frohro/Hermes-Lite/pcb/hermes_lite.jpg

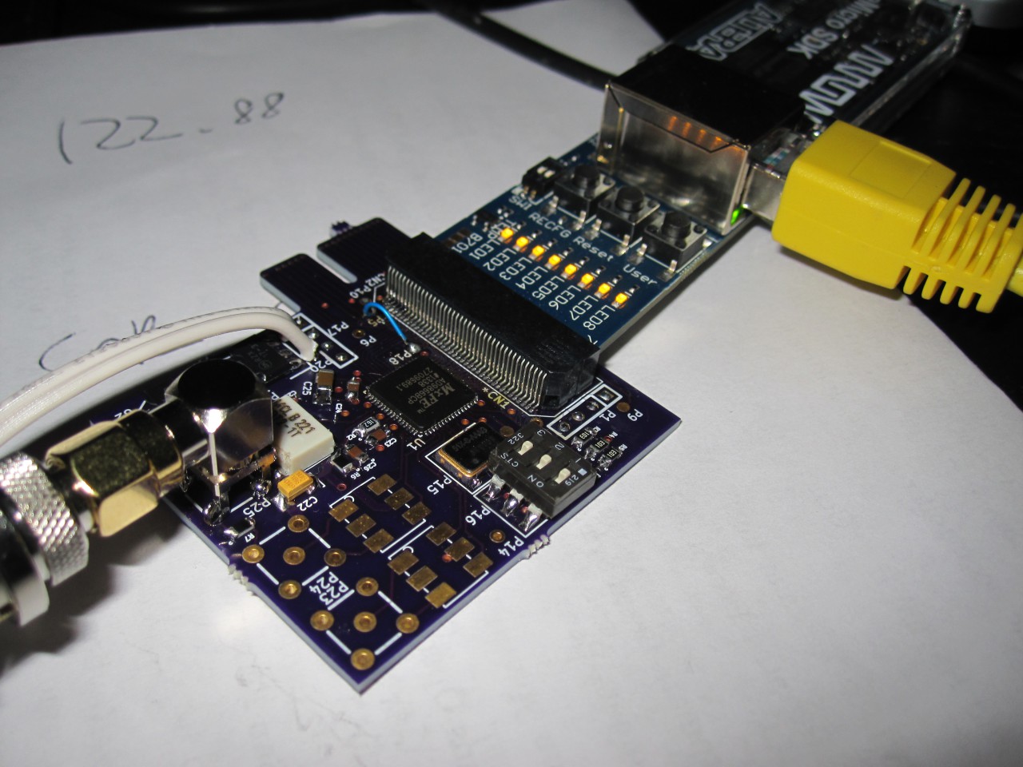
pcb/hermes_lite.jpg
