frohro/Hermes-Lite/pcb/2014-05-14 17.02.15.jpg

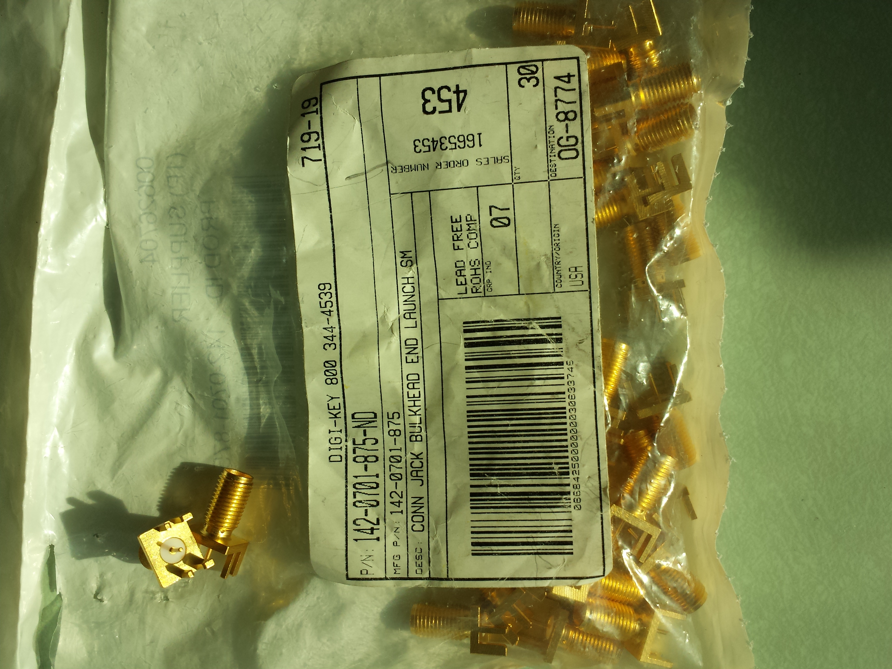
pcb/2014-05-14 17.02.15.jpg
