frohro/Hermes-Lite/pcb/bom2.xls

Designator | Quantity | Value/Description | Package | Supplier | Supplier Part # | Supplier Price | Total Price | Comments
U1 | 1 | AD9866BCPZ |  | Digi-Key | AD9866BCPZ-ND | 34.600 | 34.60
C1,C2,C3,C4,C9,C10,C11,C15,C16,C21,C23,C24,C26,C27,C28,C29,C30 | 17 | 0.1 uF | 0805 | Digi-Key | 311-1361-1-ND | 0.031 | 0.53
C5,C6,C7,C8,C12,C13,C14,C17,C18 | 9 | 1 uF | 0805 | Digi-Key | 311-1365-1-ND | 0.073 | 0.66 | Buy extra 1 for price break
C19,C20,C22,C25 | 4 | 10 uF | 1206 | Digi-Key | 399-10116-1-ND | 0.330 | 1.32 | C22 and C25 are 0805 footprint but 1206 can work
D1 | 1 | TVS Diode | SOD323 | Digi-Key | CDSOD323-T05LCCT-ND | 0.910 | 0.91 | Match voltage protection to RX transformer and AD9866 input
L1,L2,L3,L4 | 4 | Ferrite Chip | 0805 | Digi-Key | 445-1568-1-ND | 0.120 | 0.48
P15 | 1 | 73.728 Mhz XTAL |  | Digi-Key | 510CAB-AAAG-ND | 4.840 | 4.84 | Request 73.728 Mhz
P16 | 1 | 3 Pos DIP Switch |  | Digi-Key | CT2193LPST-ND | 0.690 | 0.69
R1,R3,R4,R5 | 4 | 10 K | 0805 | Digi-Key | 311-10KARCT-ND | 0.100 | 0.40
R2 | 1 | 1.6 K | 0805 | Digi-Key | 311-1.6KARCT-ND | 0.100 | 0.10
U2,U3 | 2 | 3.3 V Regulator | SOT223 | Digi-Key | NCP1117ST33T3GOSCT-ND | 0.490 | 0.98
CN1 | 1 | BeMicro Connector |  | Newark | 85T5569 | 9.990 | 9.99 | Samtec MEC6-140-02-L-D-RA1
P24, P25 | 2 | SMA Connector |  | Digi-Key | CONSMA002-ND | 3.310 | 6.62
T1 | 1 | ADT9-1T |  | Mini-Circuits | ADT9-1T | 15.950 | 15.95 | Too expensive, I bought the sampler kit, will wind my own in future
T2 | 1 | BN-43-2402 |  | Amidon | BN-43-2402 | 0.700 | 0.70 | 3T bifilar on primary, 5T on secondary, 1.2:1 ratio, need 1.41 in future
FPGA | 1 | BeMicro SDK |  | Arrow | BEMICRO SDK | 35.860 | 35.86 | While supplies last, use BeMicro CV in future?
PCB | 1 | PCB |  | OshPark | Gerber Files | 38.700 | 38.70 | 1 Batch of 3 boards, other suppliers may be cheaper
 |  | Micro USB B jack |  | Digi-Key | 609-4618-1-ND | 0.460 | 0.46 | FCI 10118194-0001LF
 |  |  |  |  |  |  | 153.32
