frohro/Hermes-Lite/pcb/ad9866.ods

Id | Designator | Package | Quantity | Designation | Supplier and ref
1 | P25,P24,P23 | SMA_EDGE:SMA_EDGE | 3 | CONN_2
2 | U1 | AD986:CP_64_3-M | 1 | AD9866BCPZ
3 | C1,C2,C3,C4,C9,C10,C11,C15,C16,C21,C23,C24,C26,C27,C28,C29,C30 | SMD_Packages:SM0805 | 17 | 0.1UF
4 | C5,C6,C7,C8,C12,C13,C14,C17,C18 | SMD_Packages:SM0805 | 9 | 1UF Rob substituted 10UF Ceramics
5 | C19,C20,C22 | SMD_Packages:SM1206POL | 3 | 10UF Rob substituted 33UF
6 | C25 | SMD_Packages:SM1206 | 1 | 10UF
7 | D1 | SOD:SOD323 | 1 | CDSOD323
8 | L1,L2,L3,L4 | SMD_Packages:SM0805 | 4 | FB
9 | P15 | SILABS:Si510 | 1 | Si510 73.728
10 | R1 | SMD_Packages:SM0805 | 1 | 10K
11 | R2 | SMD_Packages:SM0805 | 1 | 1.6K
12 | R6,R7 | SMD_Packages:SM0805 | 2 | DNI
13 | T2,T3 | MINICKTS:minicircuits-CD542 | 2 | TRANSF_ADT2
14 | U2,U3 | SMD_Packages:SOT223 | 2 | NCP1117ST33T3G
15 | P8,P13,P20,P6,P14,P19 | Measurement_Points:Measurement_Point_Round-TH_Small | 6 | CONN_1
16 | P9,P10,P22 | Measurement_Points:Measurement_Point_Round-SMD-Pad_Small | 3 | CONN_1
17 | T1 | MINICKTS:minicircuits-CD542 | 1 | TRANSF_ADT8
18 | CN1 | BEMICRO:MEC6-140-02-X-D-RAX | 1 | MEC6-140_CONNECTOR_BEMICRO
19 | P1 | Pin_Headers:Pin_Header_Straight_1x02 | 1 | CONN_2
 | Red font for surface mount front, Blue font for surface mount back
