frohro/Hermes-Lite/pcb/micro-b-usb-3D/AB2_USB_MICRO_SMD.stl

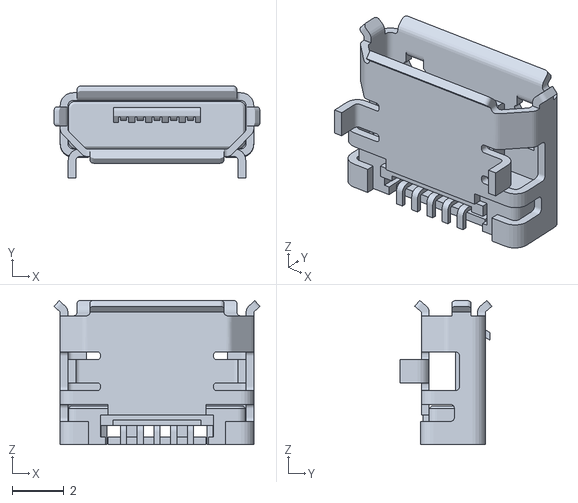
[picture p3: CAD file, 2014-06-20]
pcb/micro-b-usb-3D/AB2_USB_MICRO_SMD.stl
8.00 x 3.57 x 5.60
