frohro/Hermes-Lite/pcb/SCM_BeMicroSDK-A2-1.pdf

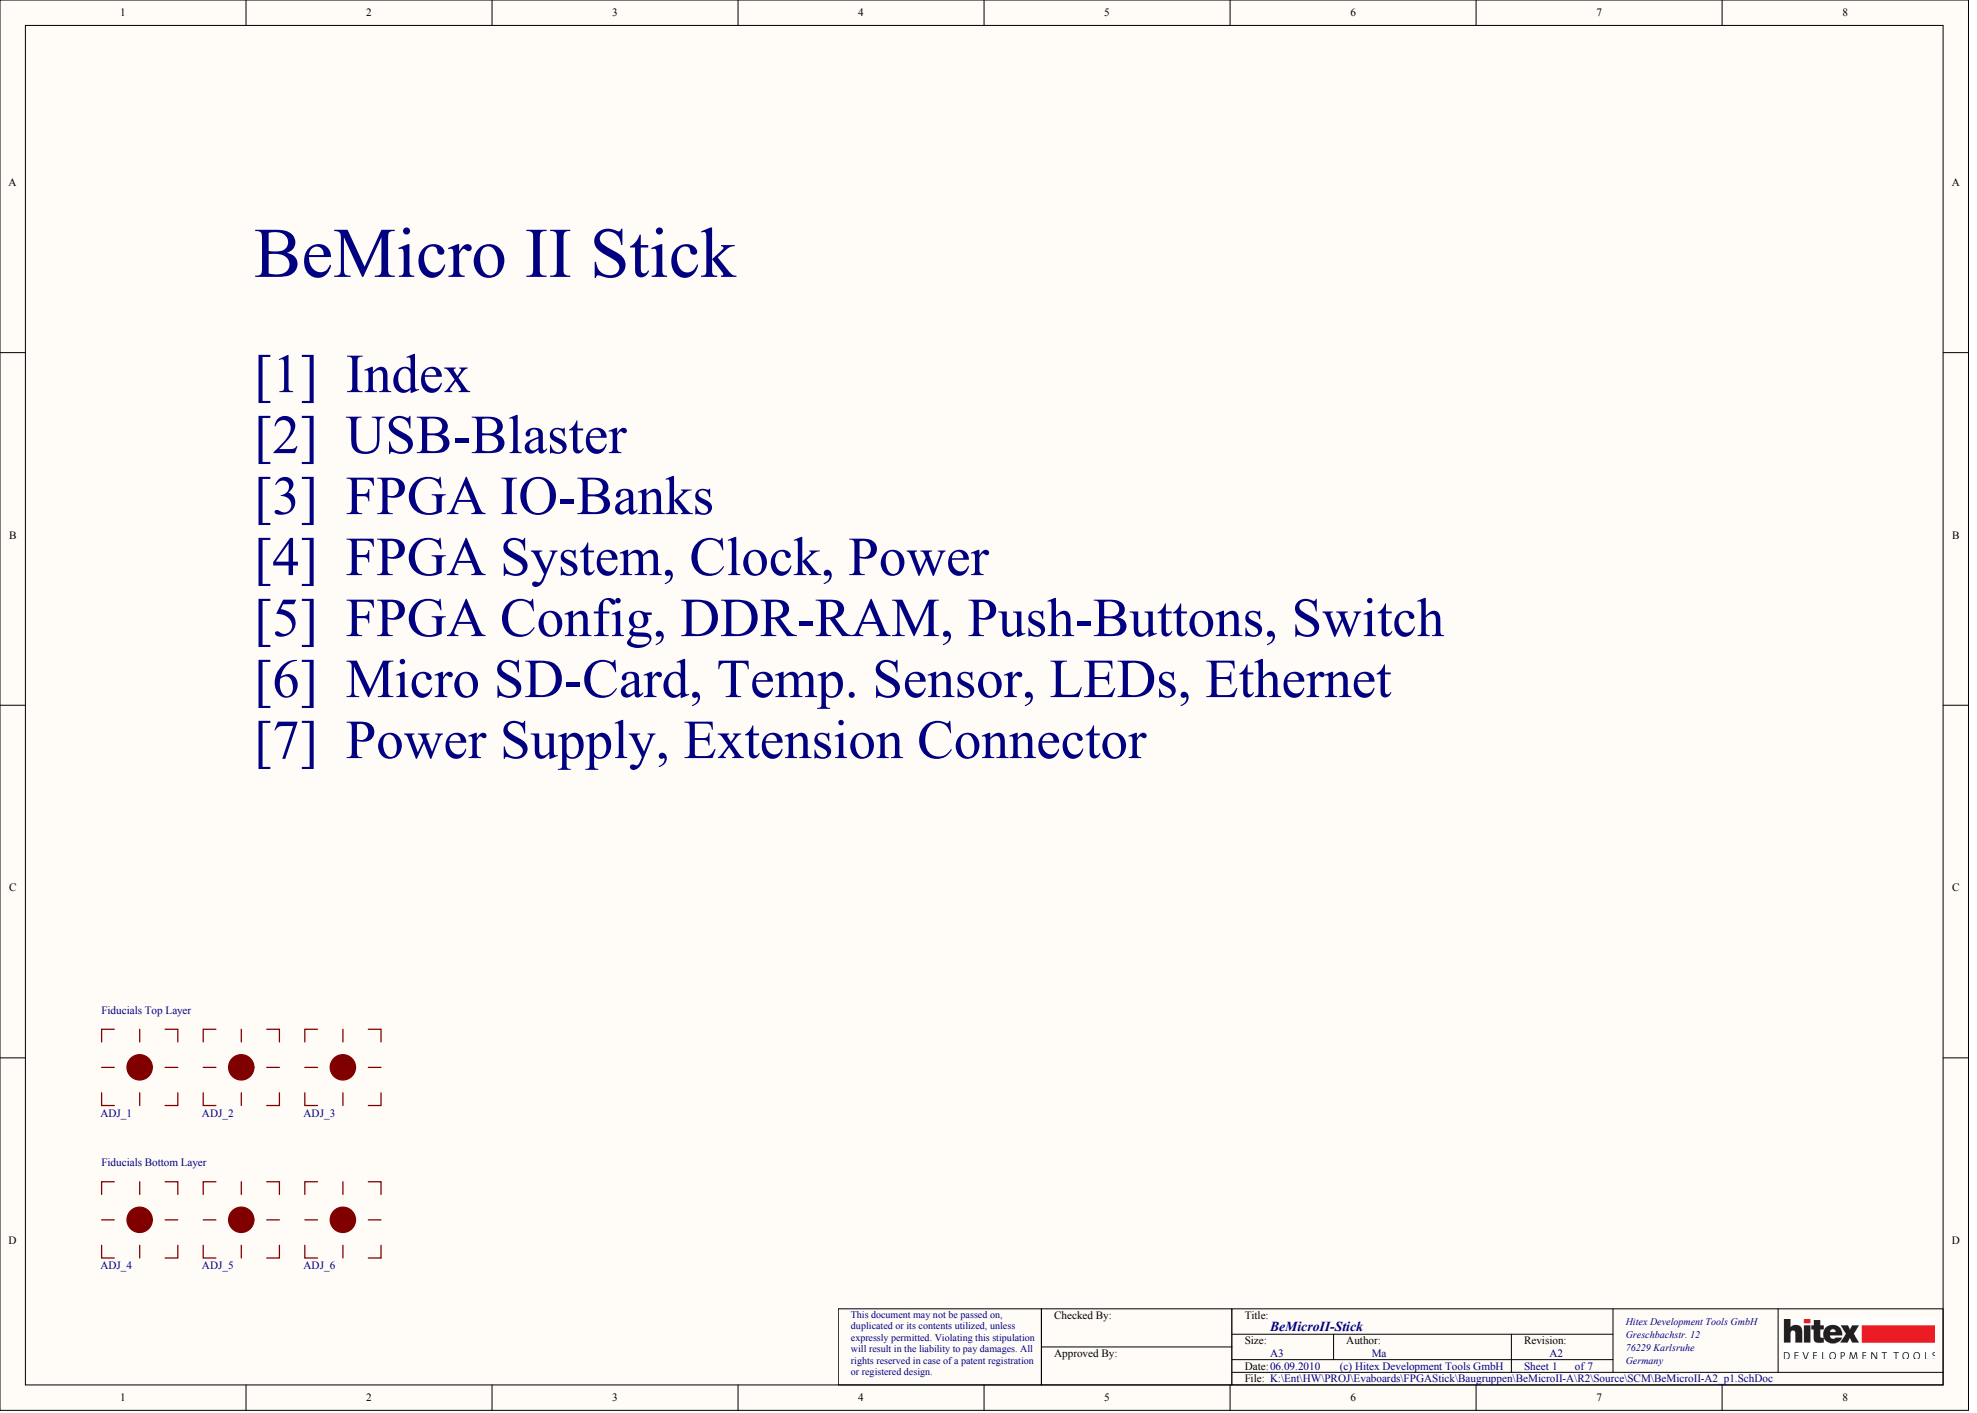
[picture p4: page 1]

[1] Index
[2] USB-Blaster
[3] FPGA IO-Banks
[4] FPGA System, Clock, Power
[5] FPGA Config, DDR-RAM, Push-Buttons, Switch
[6] Micro SD-Card, Temp. Sensor, LEDs, Ethernet
[7] Power Supply, Extension Connector

This document may not be passed on, duplicated or its contents utilized, unless expressly permitted. Violating this stipulation will result in the liability to pay damages. All rights reserved in case of a patent registration or registered design. | Checked By: | Title: BeMicroII-Stick | Hitex Development Tools GmbH Greschbachstr. 12 76229 Karlsruhe

Size: A3 | Author: Ma | Revision: A2

Date: 06.09.2010 (c) Hitex Development Tools GmbH | | of 7 | Germany Sheet 1

K:\Ent\HW\PROJ\Evaboards\FPGAStick\Baugruppen\BeMicroII-A\R2\Source\SCM\BeMicroII-A2_p1.SchDoc

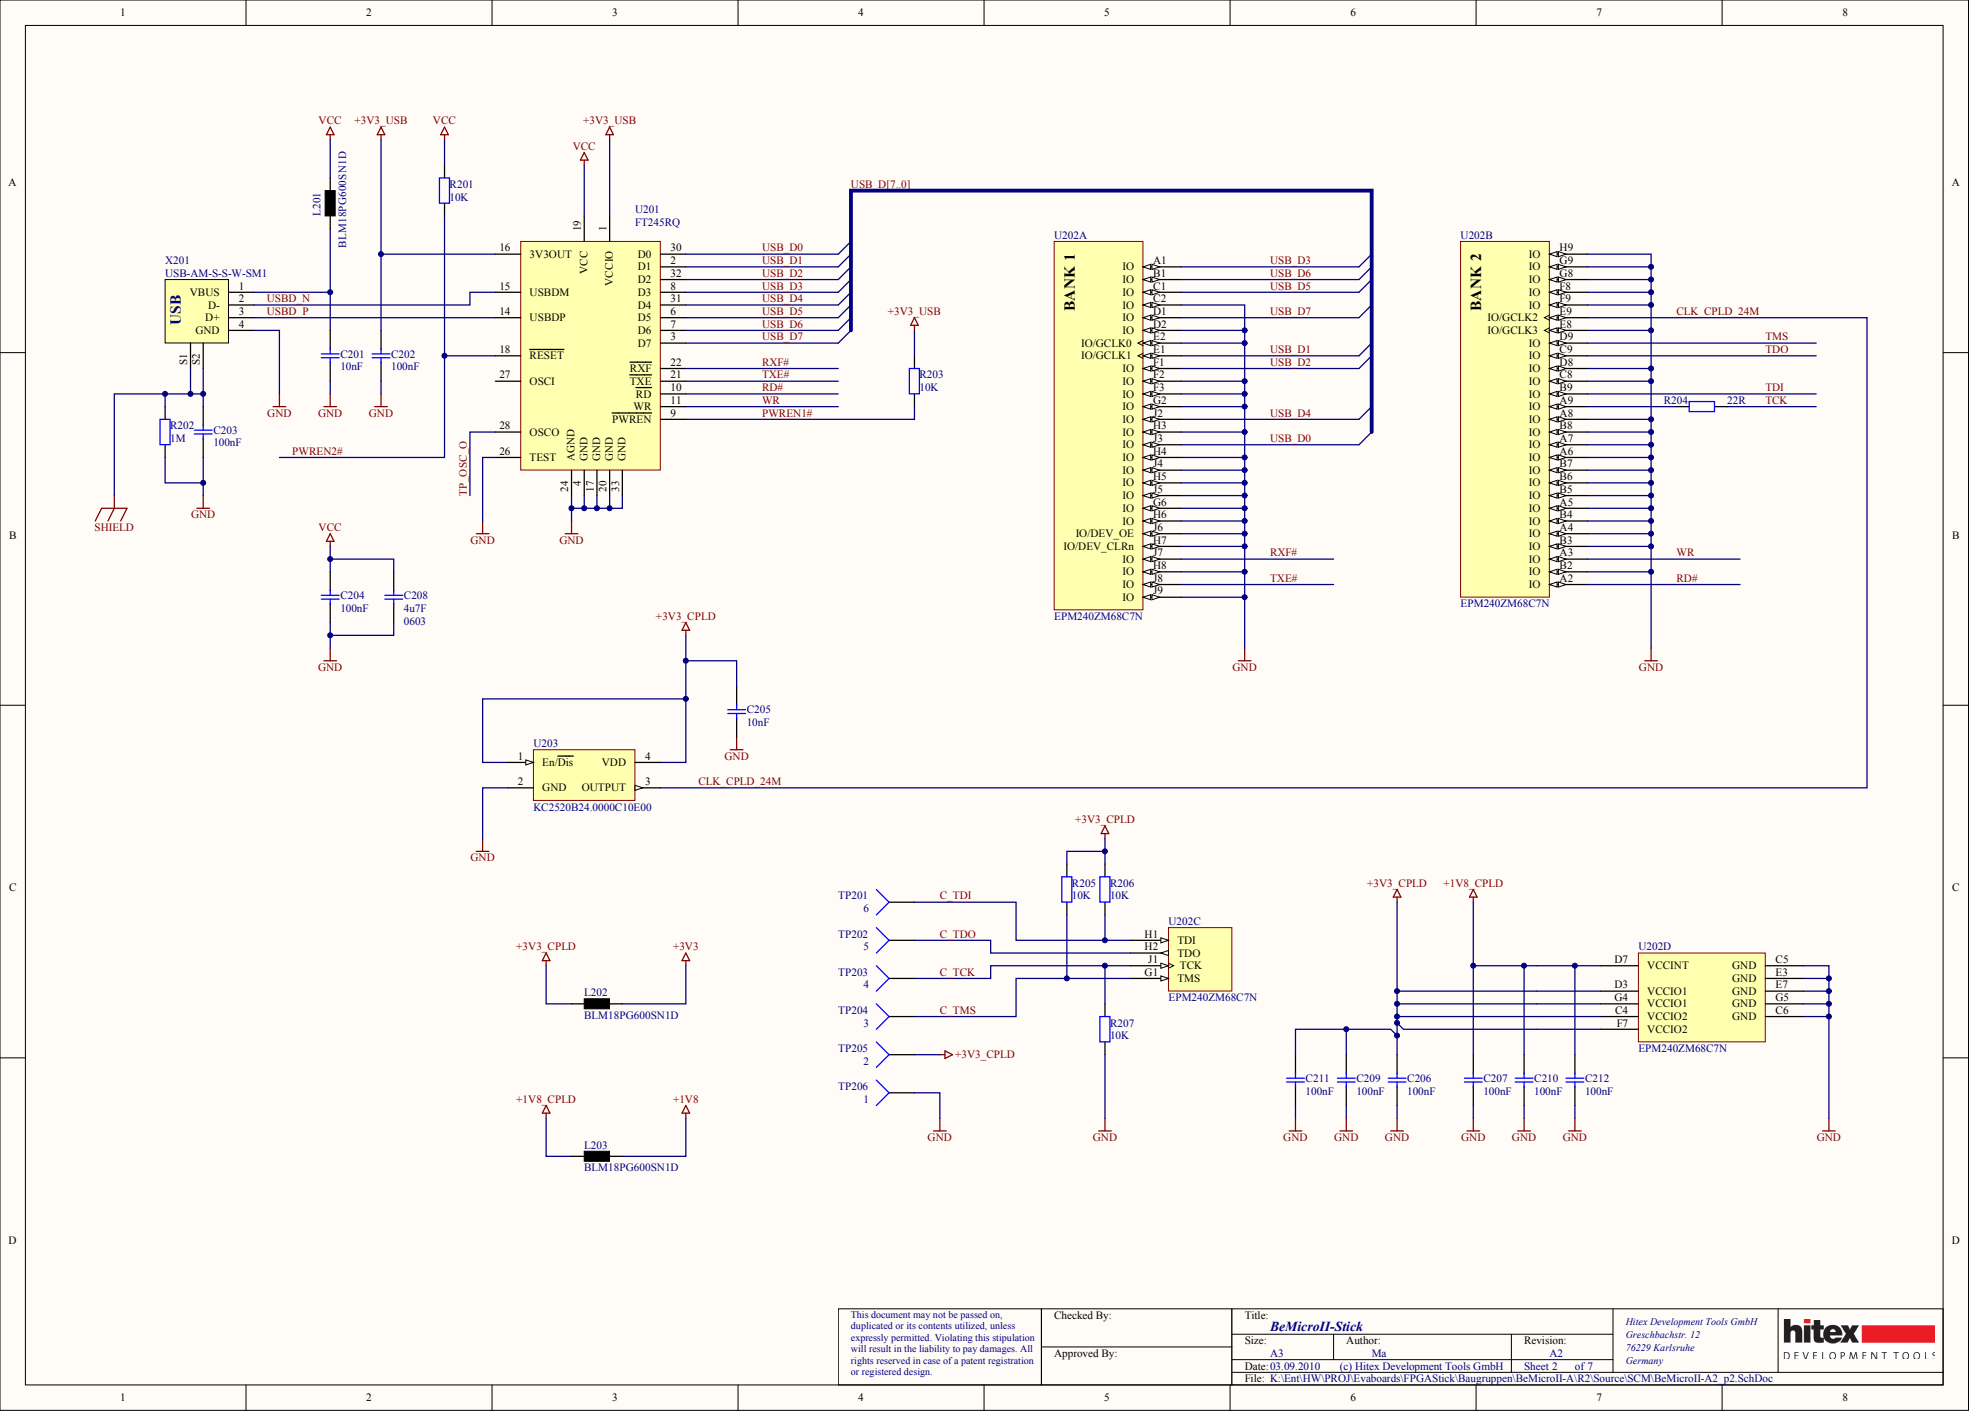
[picture p5: page 2]

K:\Ent\HW\PROJ\Evaboards\FPGAStick\Baugruppen\BeMicroII-A\R2\Source\SCM\BeMicroII-A2_p2.SchDoc

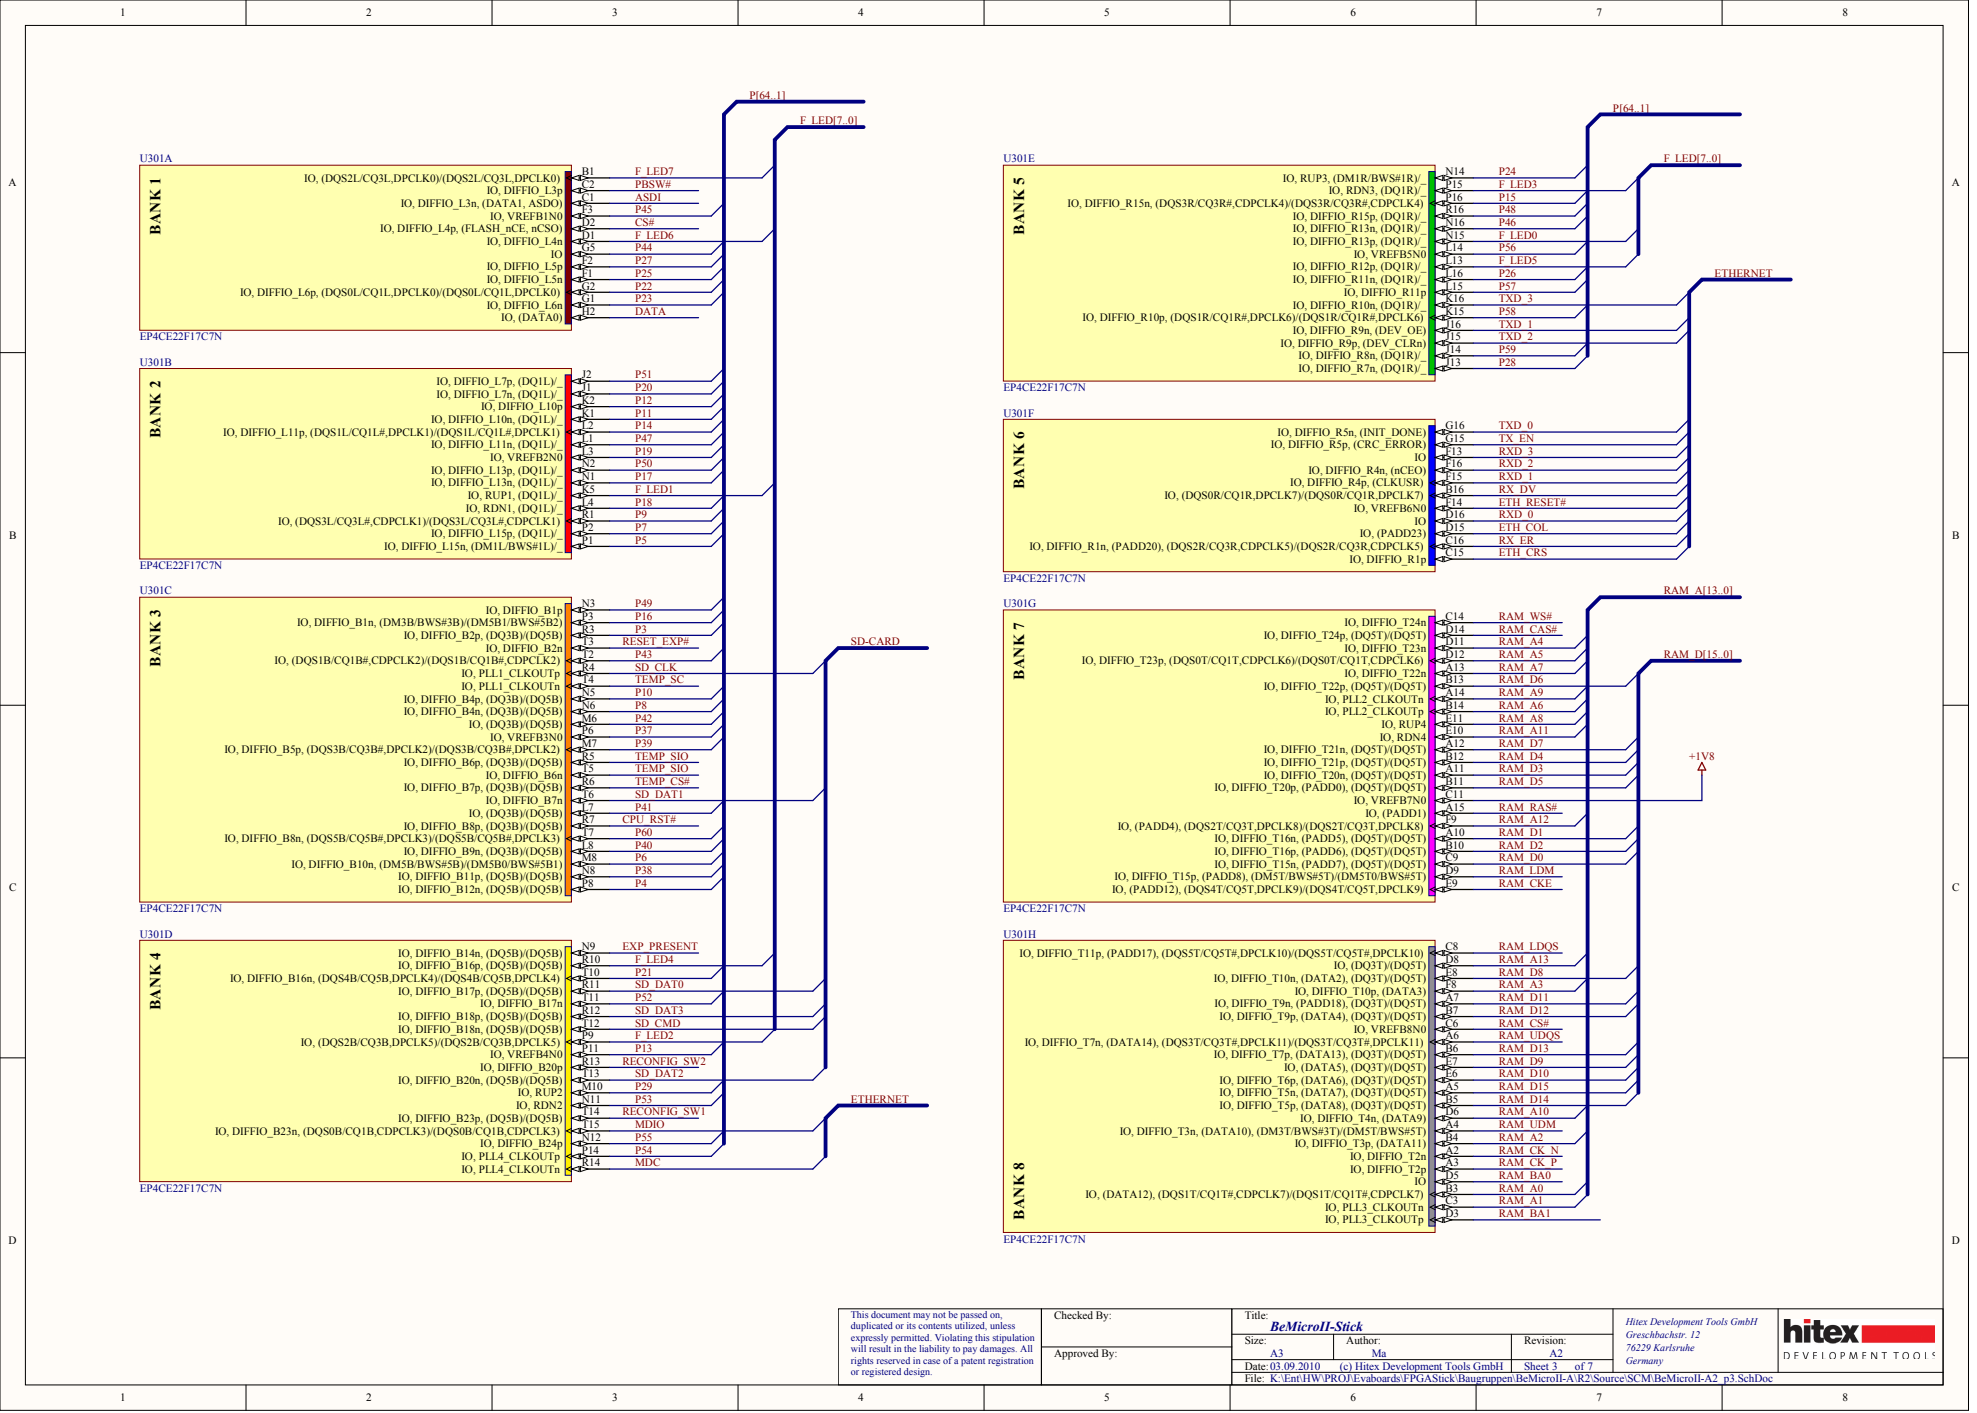
[picture p6: page 3]

03.09.2010 K:\Ent\HW\PROJ\Evaboards\F

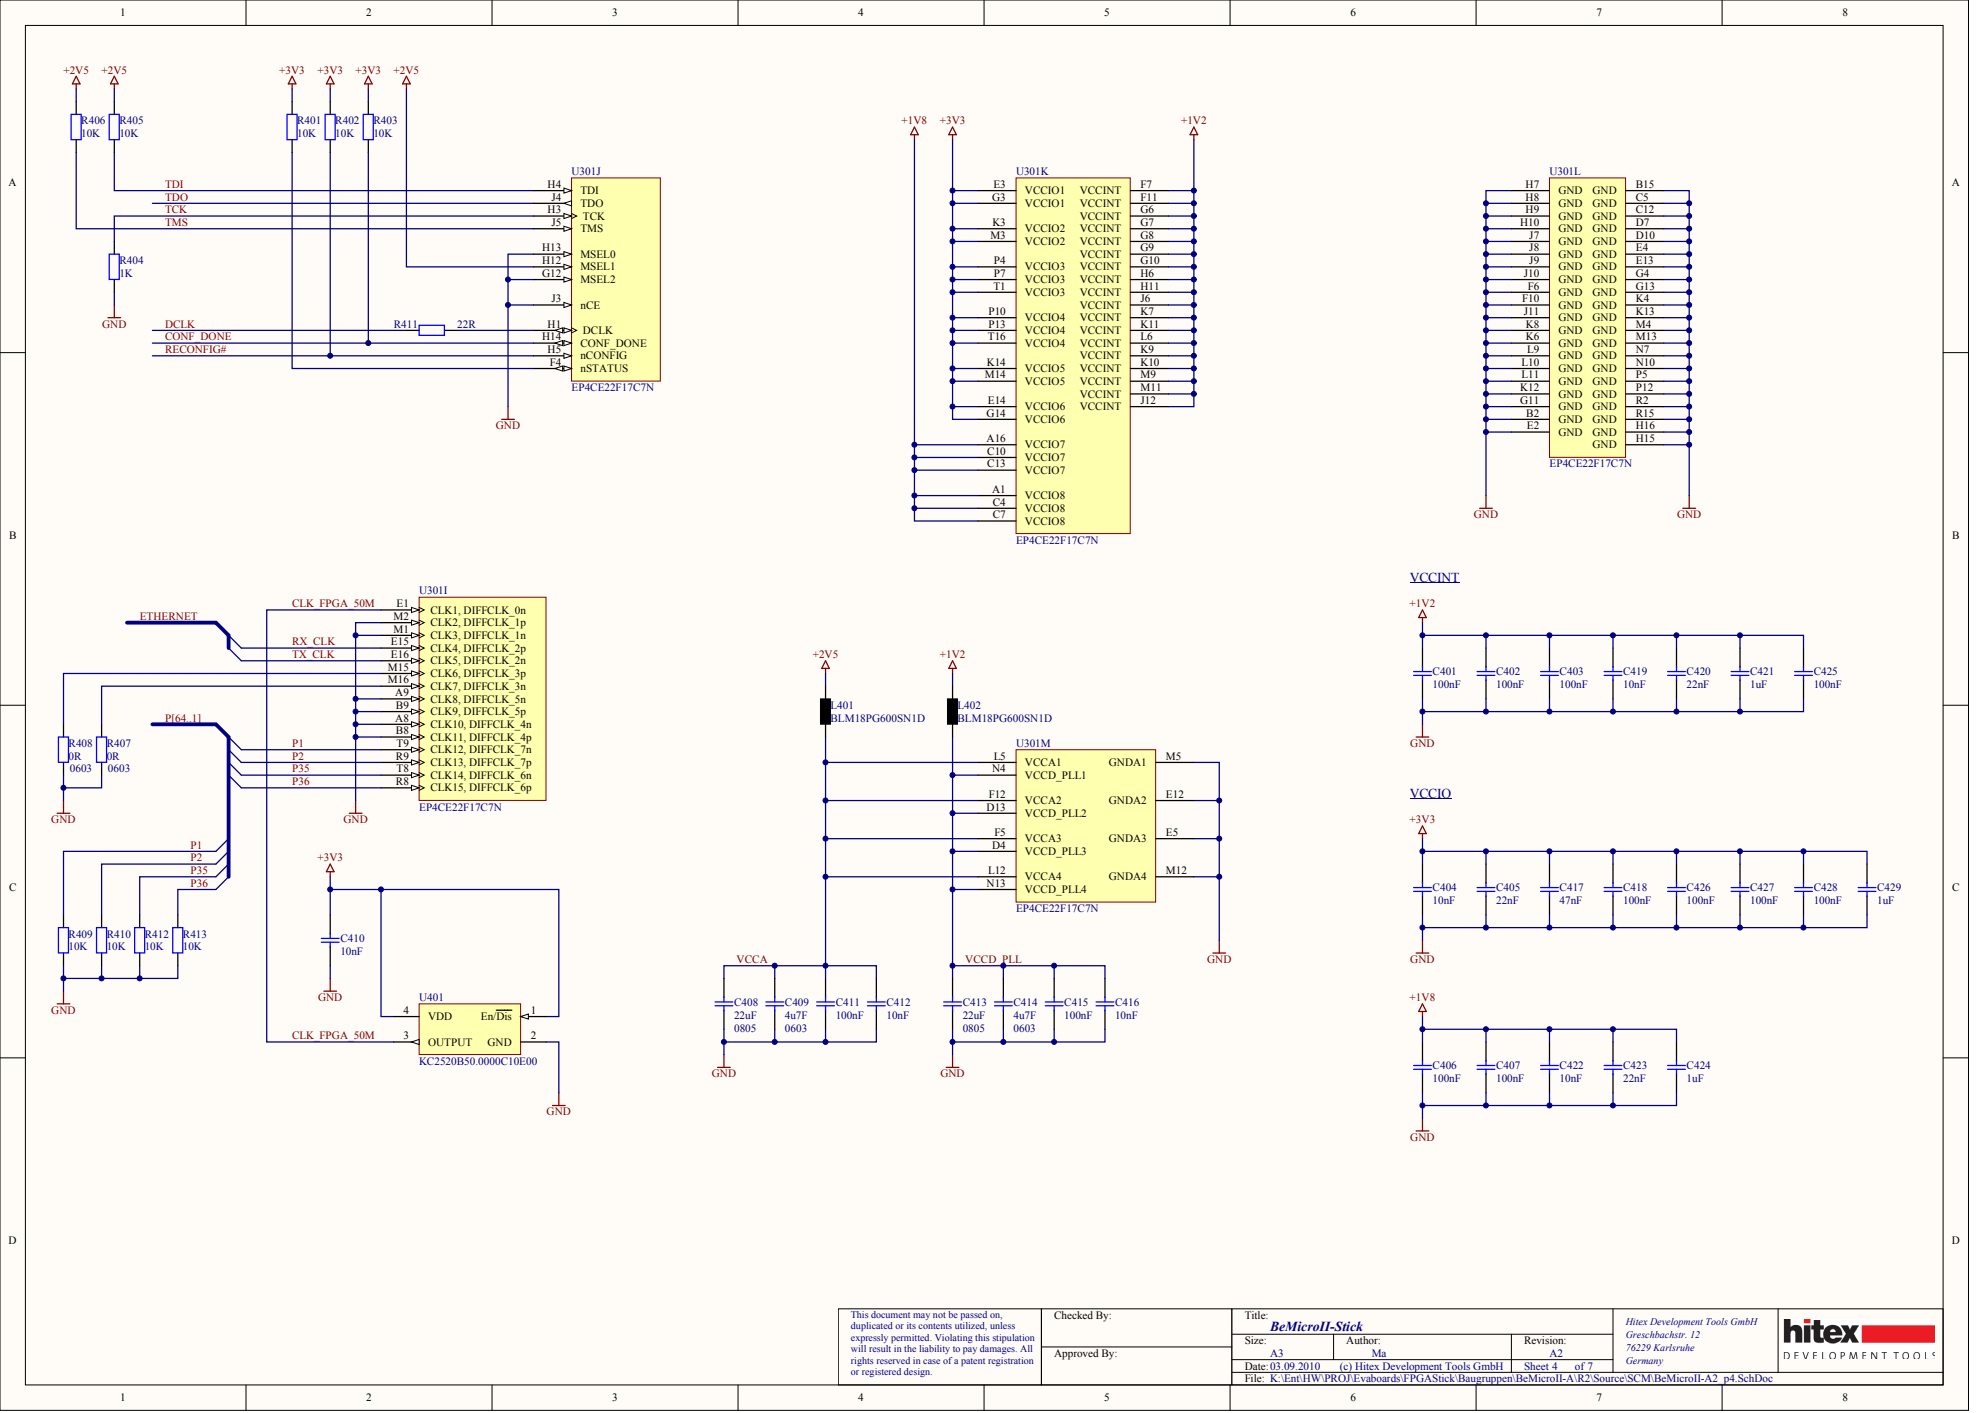
[picture p7: page 4]

VCCIO7 C10
VCCIO7 C13

VCCIO8 A1
VCCIO8 C4
VCCIO8 C7

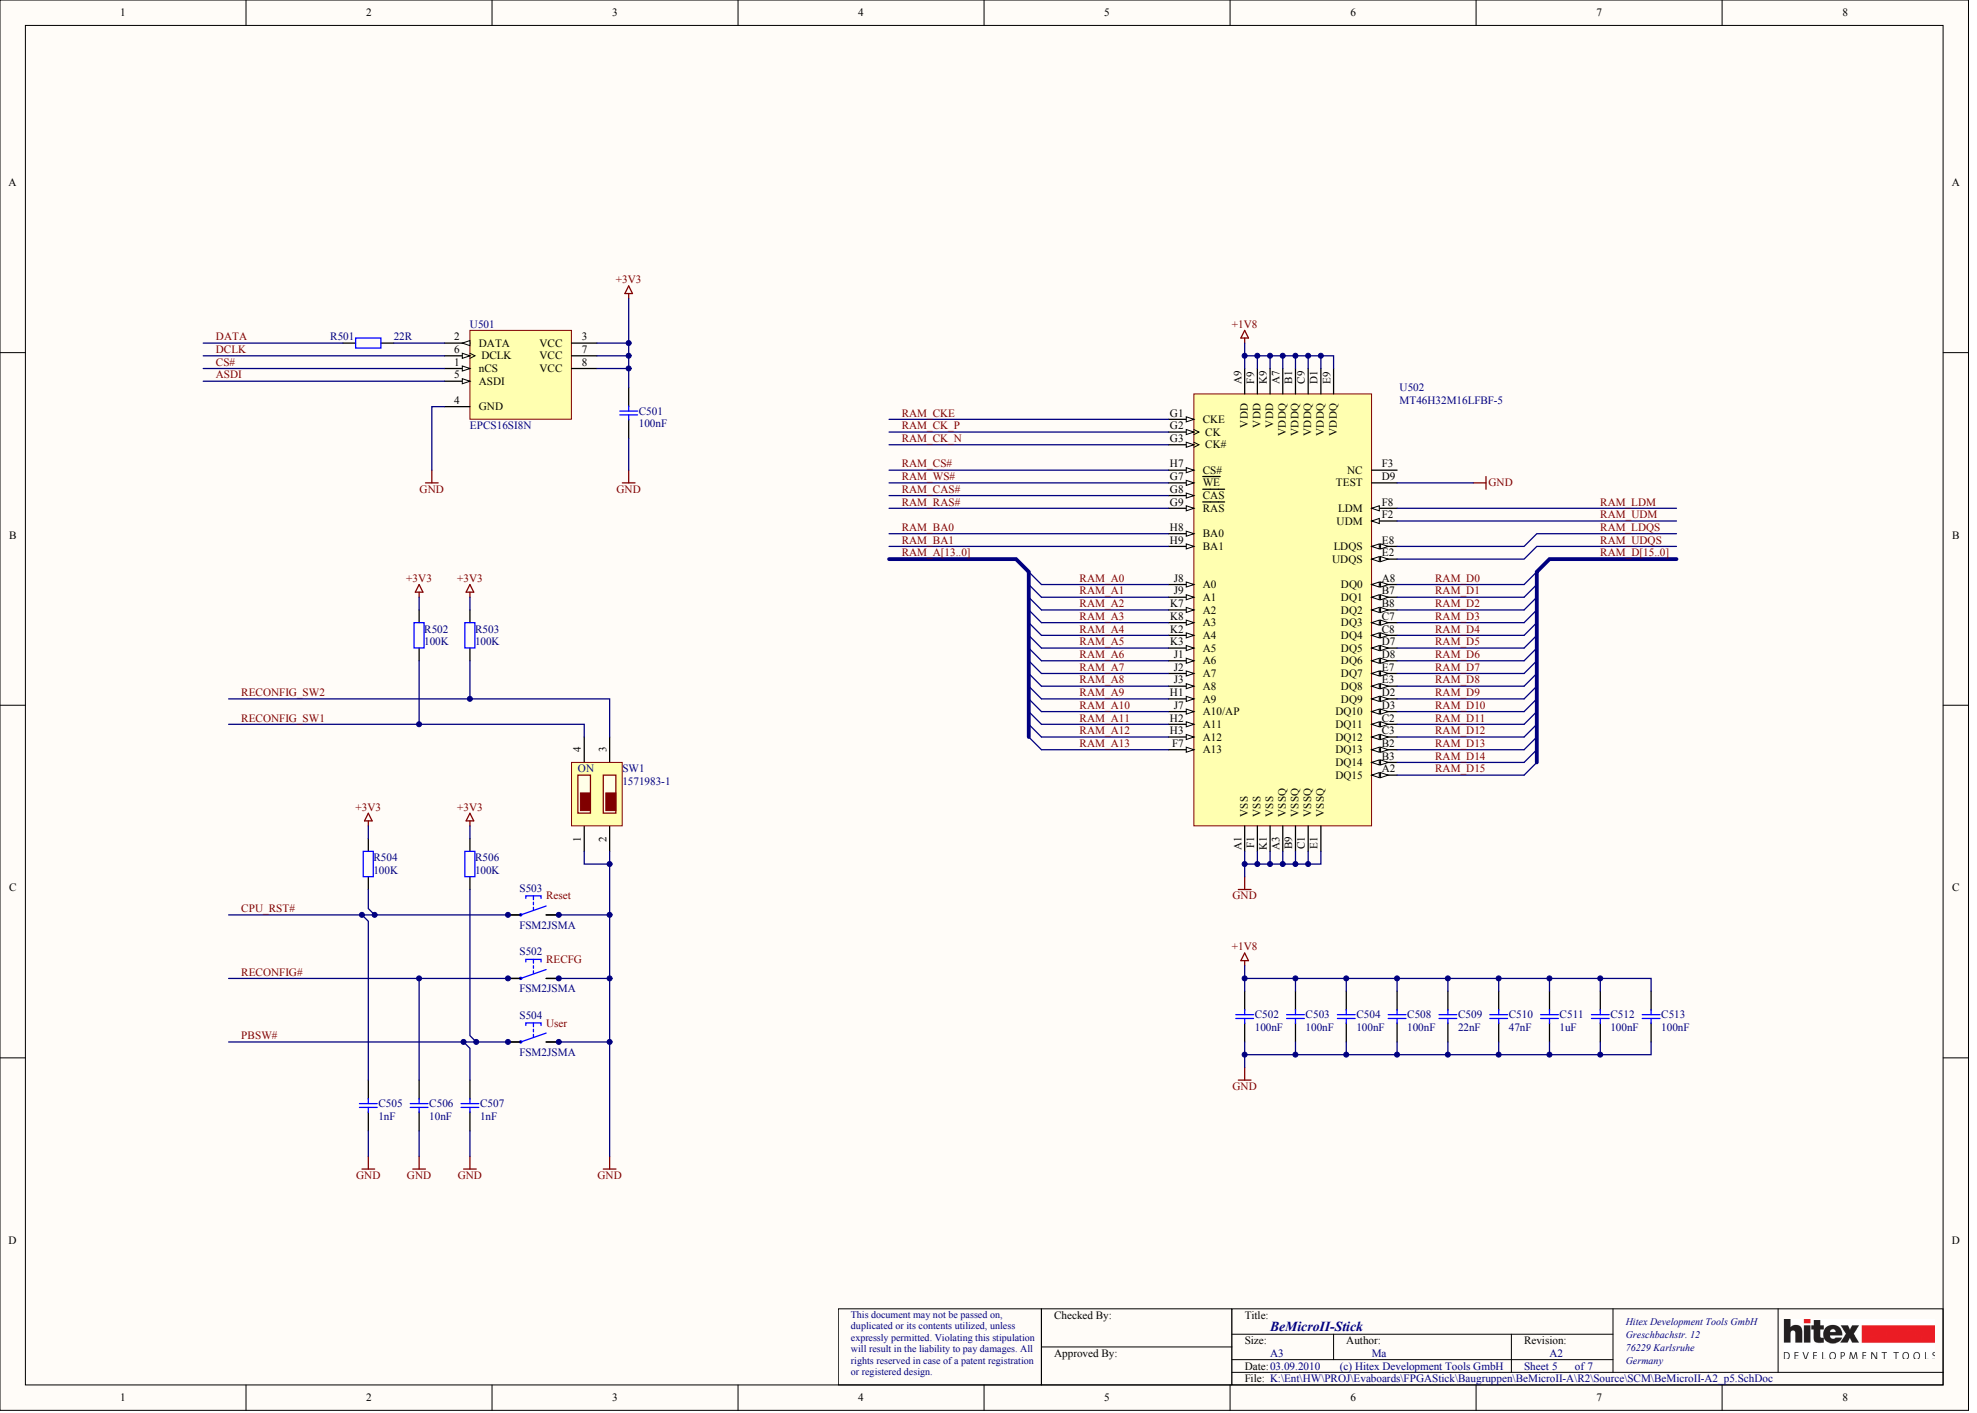
[picture p8: page 5]

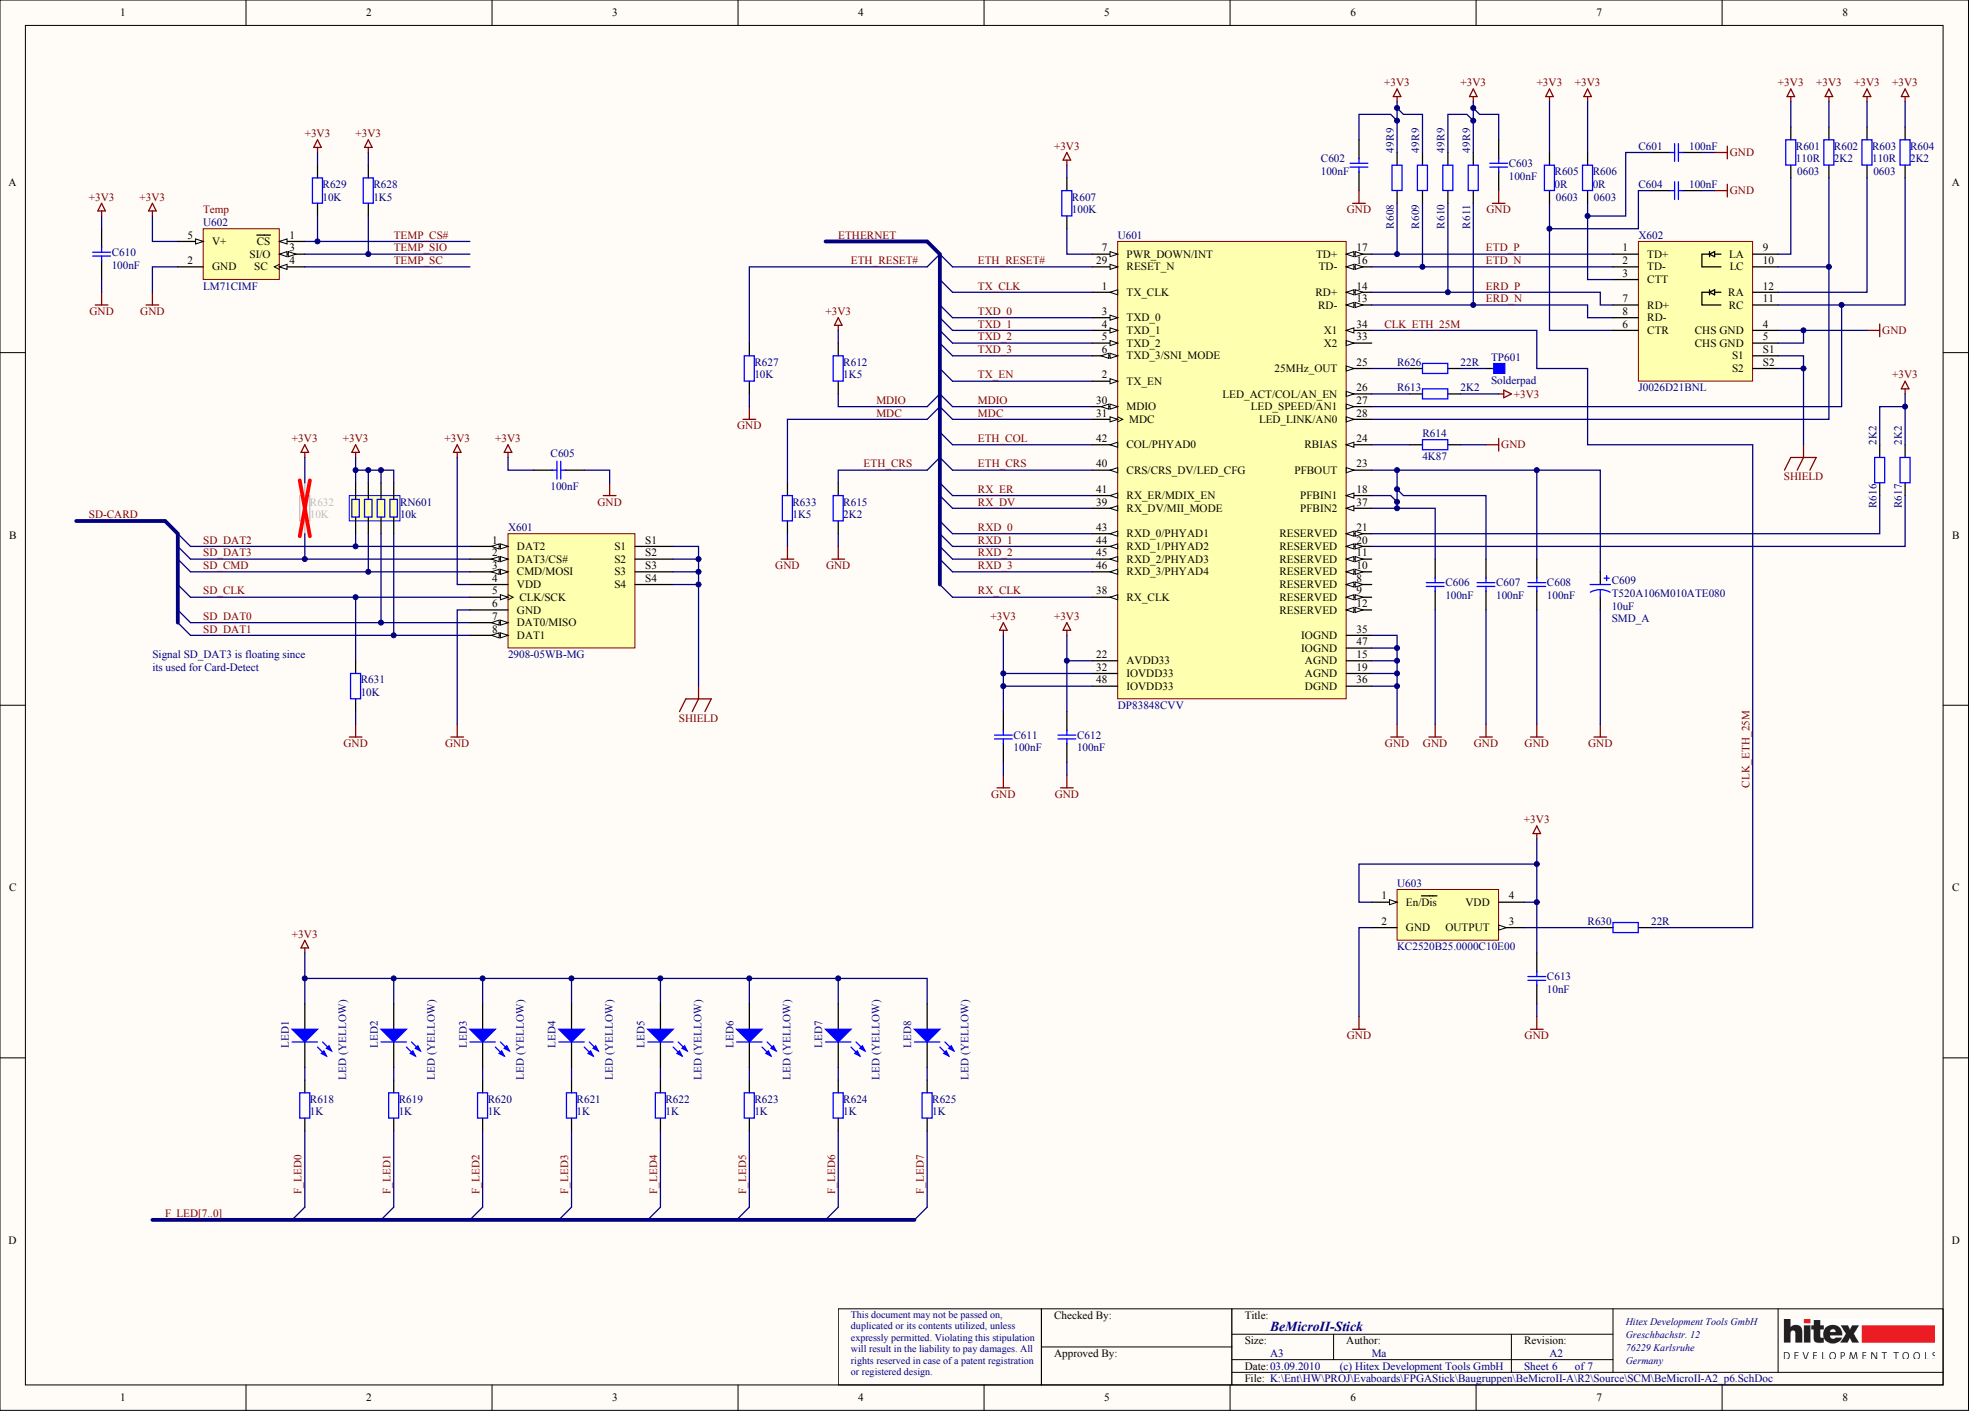
[picture p9: page 6]

Signal SD_DAT3 is floating since
its used for Card-Detect

K:\Ent\HW\PROJ\Evaboards\FPGAStick\Baugruppen\BeMicroII-A\R2\Source\SCM\BeMicroII-A2_p6.SchDoc

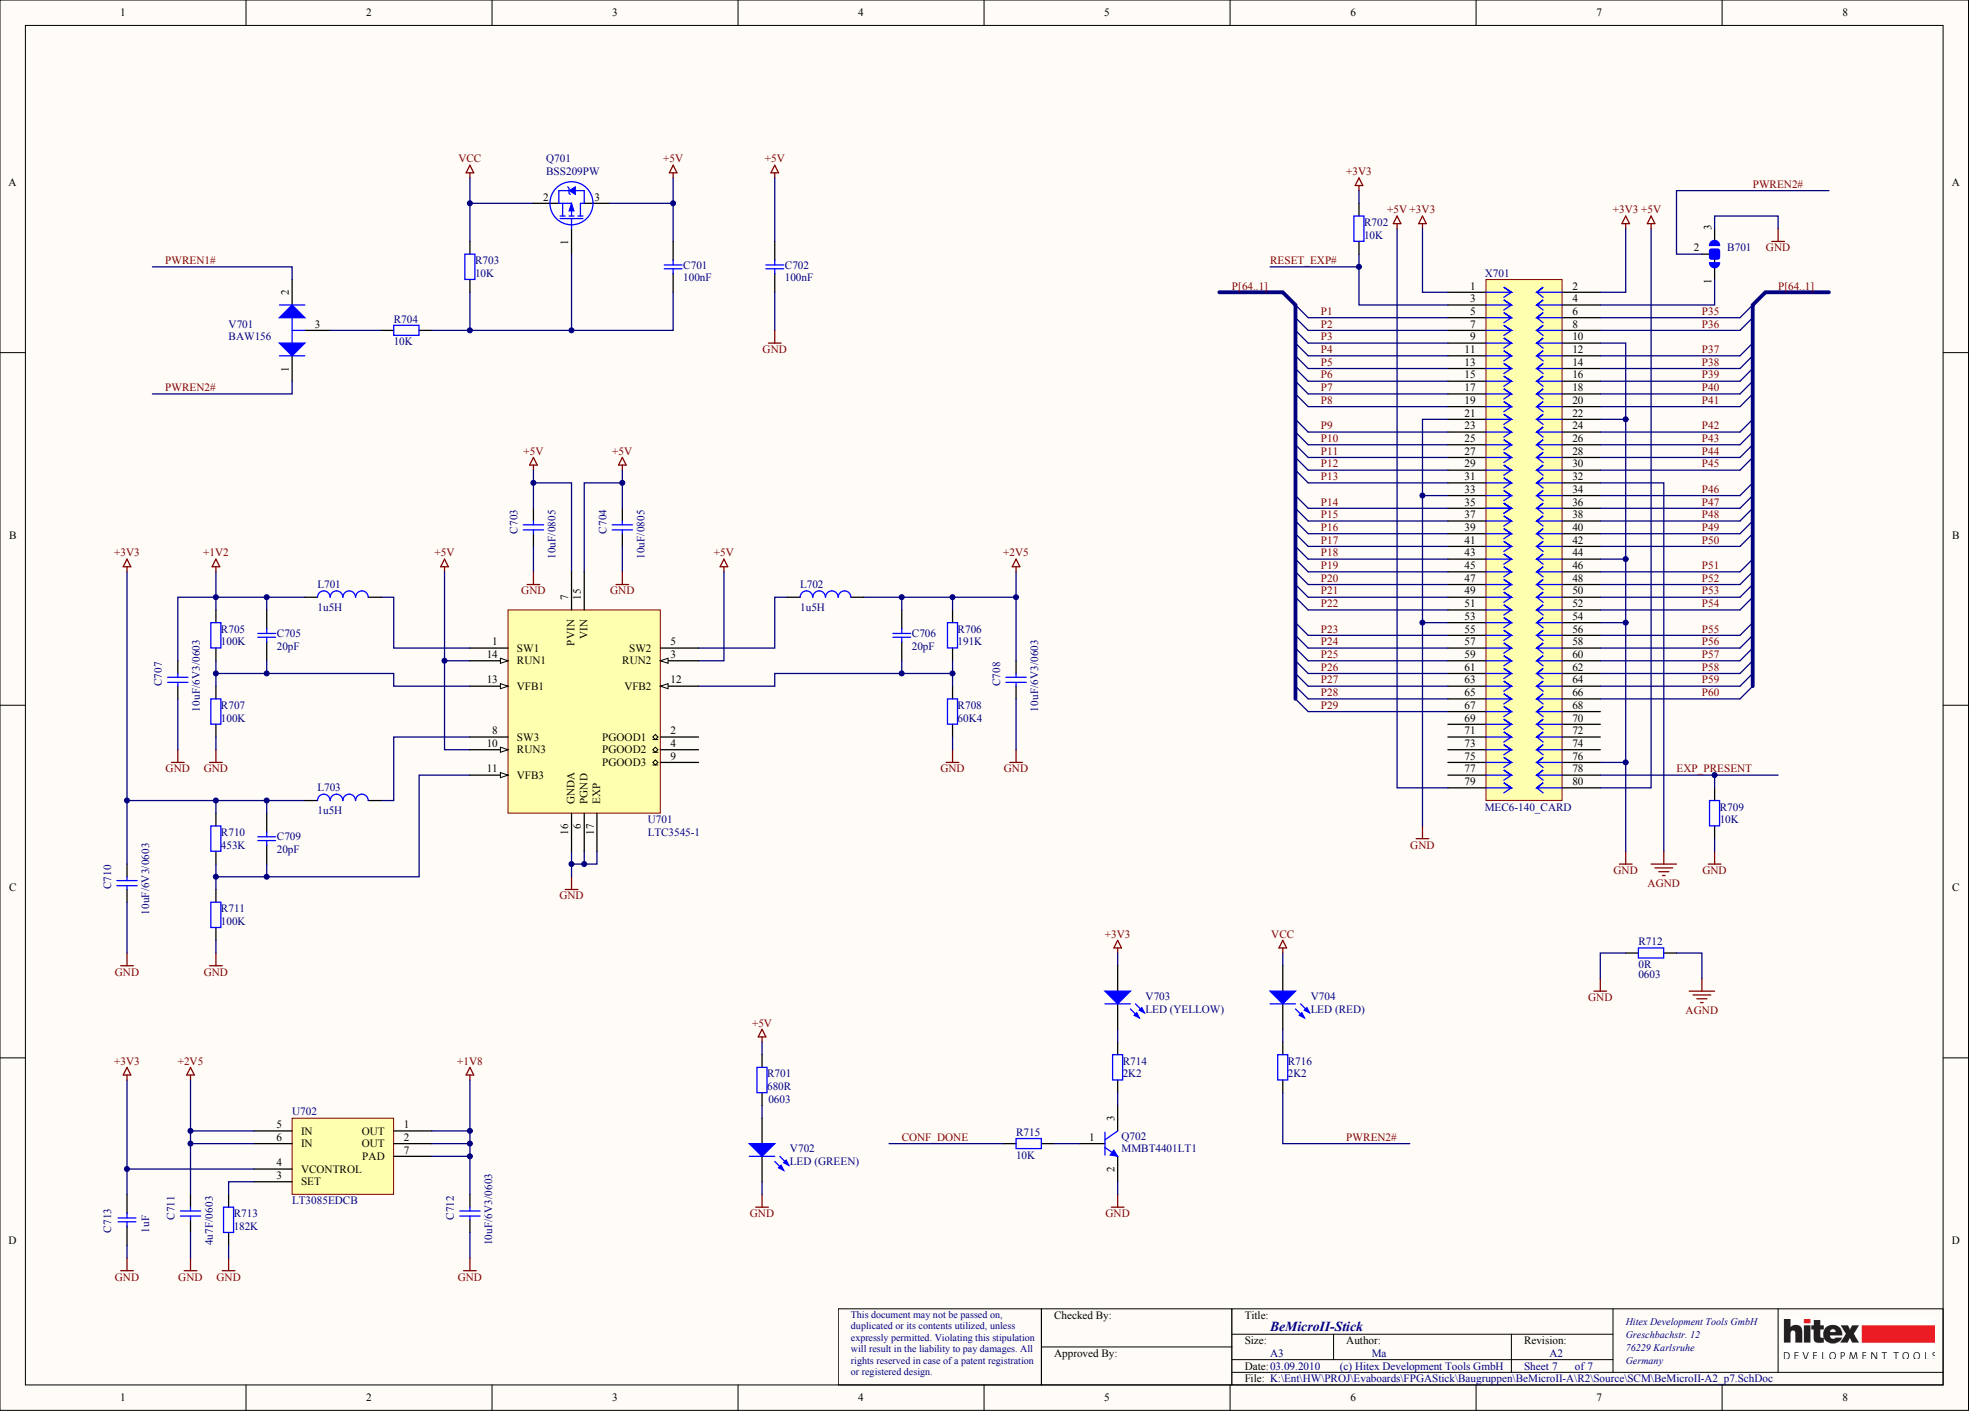
[picture p10: page 7]

5 7 9 11 13 15 17 19 21 | | 6 8 10

34 36 38 40 42 44
35 37 39 41 43 45 47 49 51 53
