frohro/Hermes-Lite/pcb/PDF Plots/ad9866_2test-Inner1_Cu.pdf

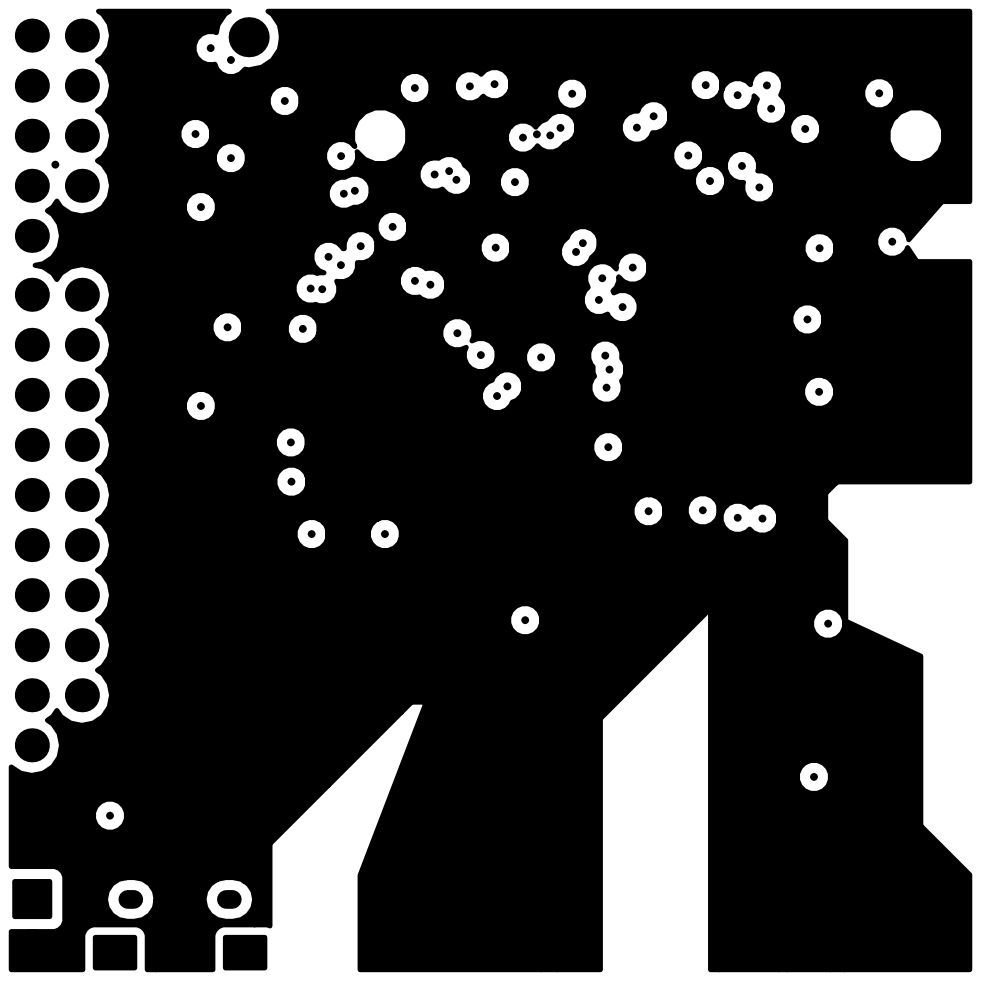
[picture p11: page 1]
