frohro/Hermes-Lite/pcb/PDF Plots/ad9866_2test-Inner2_Cu.pdf

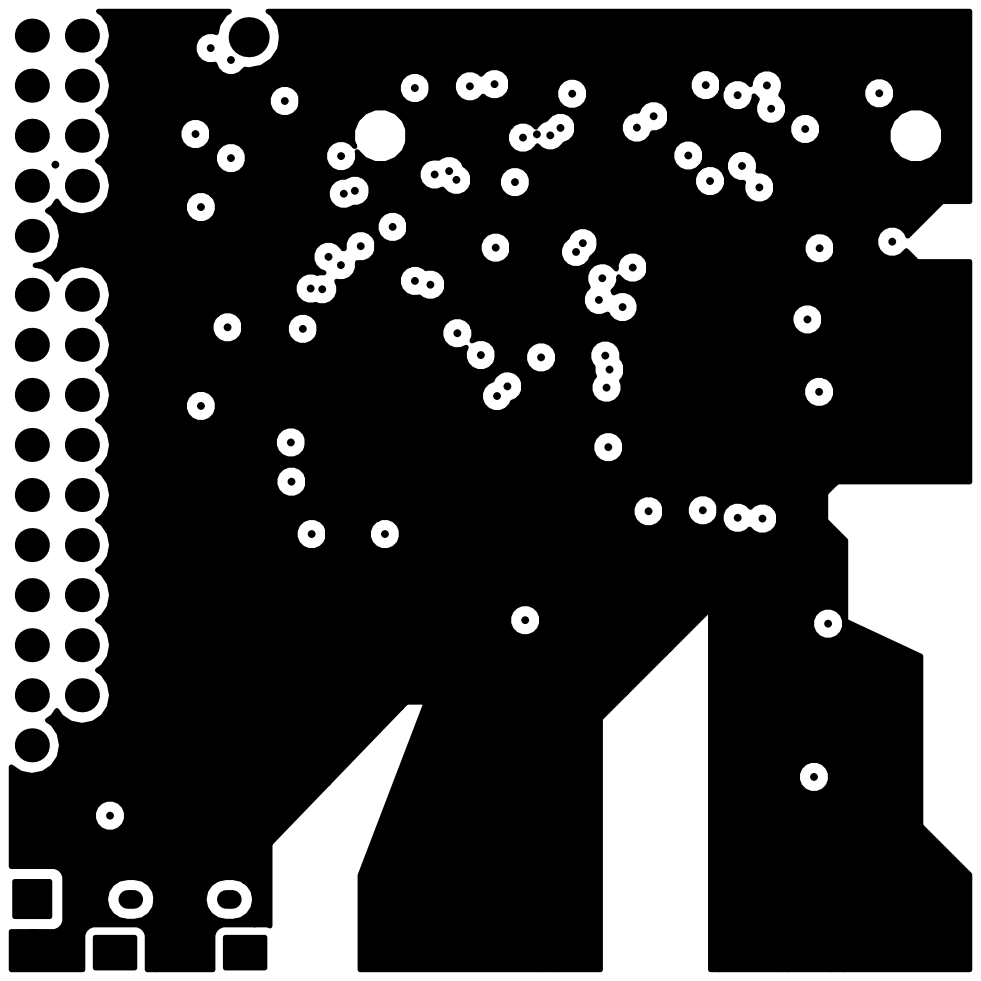
[picture p12: page 1]
