frohro/Hermes-Lite/pcb/ad9866_2-B_Cu.pdf

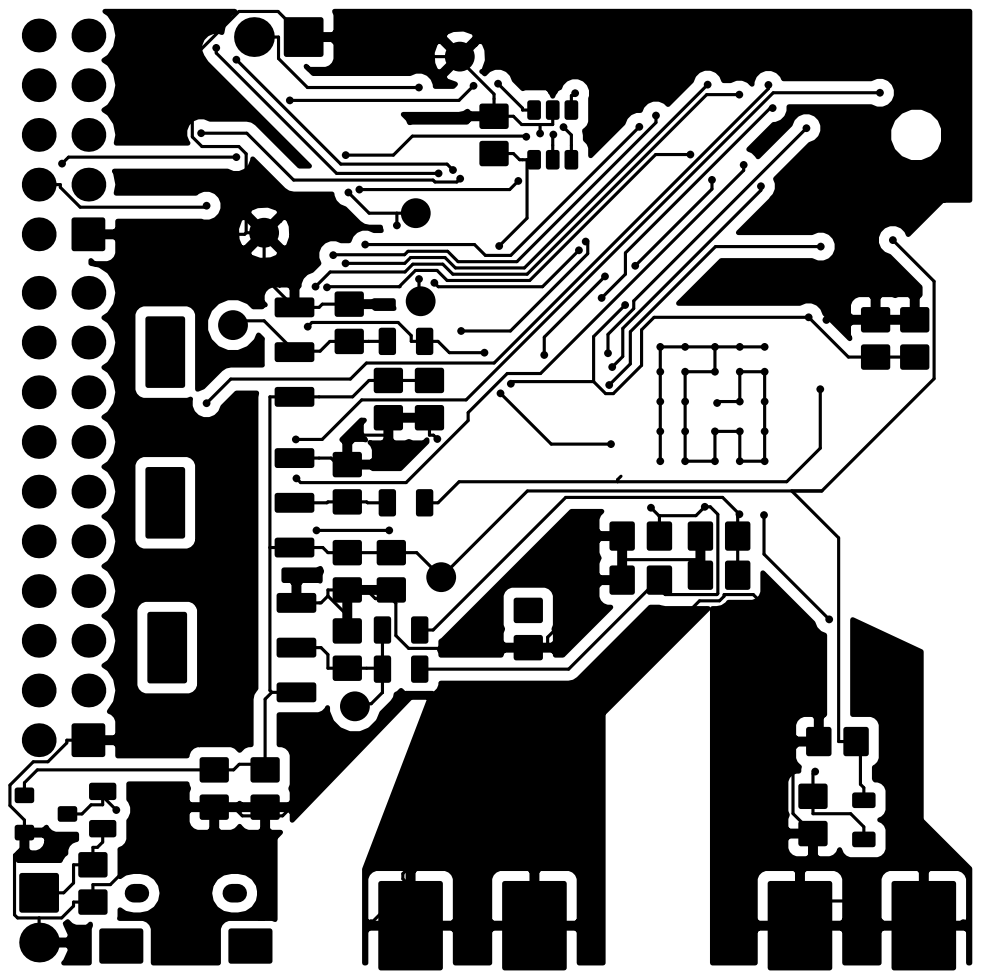
[picture p26: page 1]
