frohro/Hermes-Lite/pcb/ad9866_2-B_SilkS.pdf

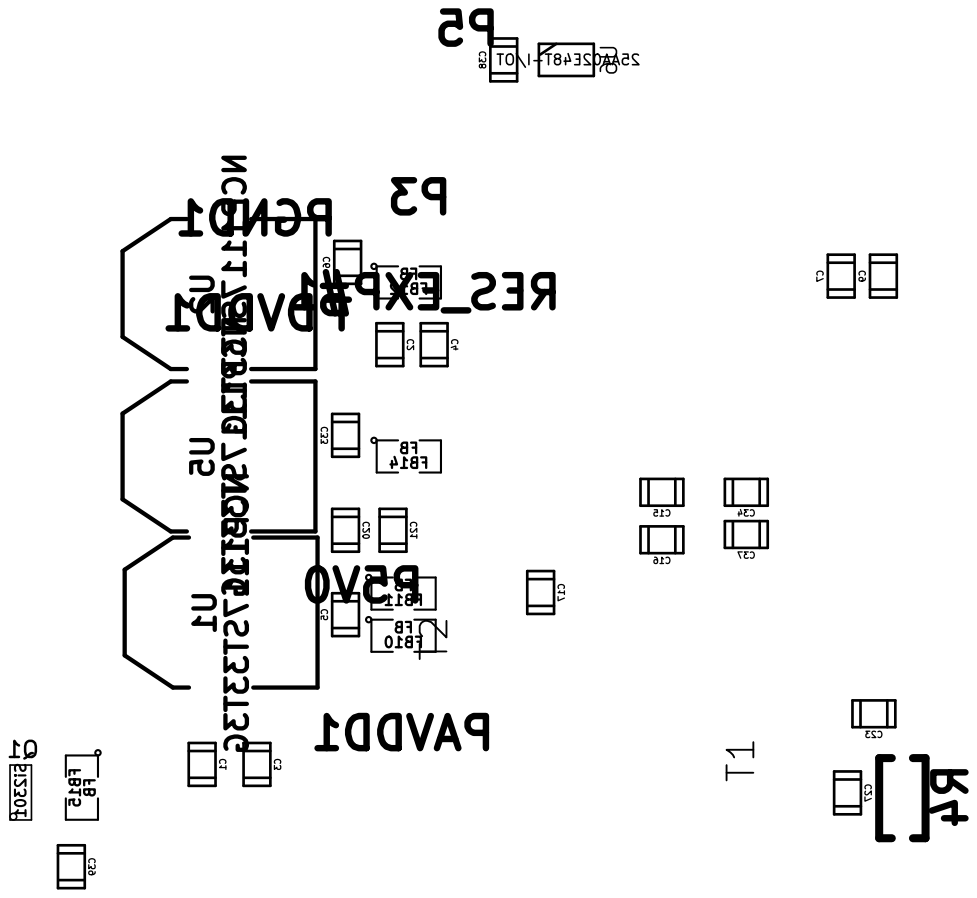
[picture p27: page 1]
