frohro/Hermes-Lite/pcb/ad9866_2-F_Cu.pdf

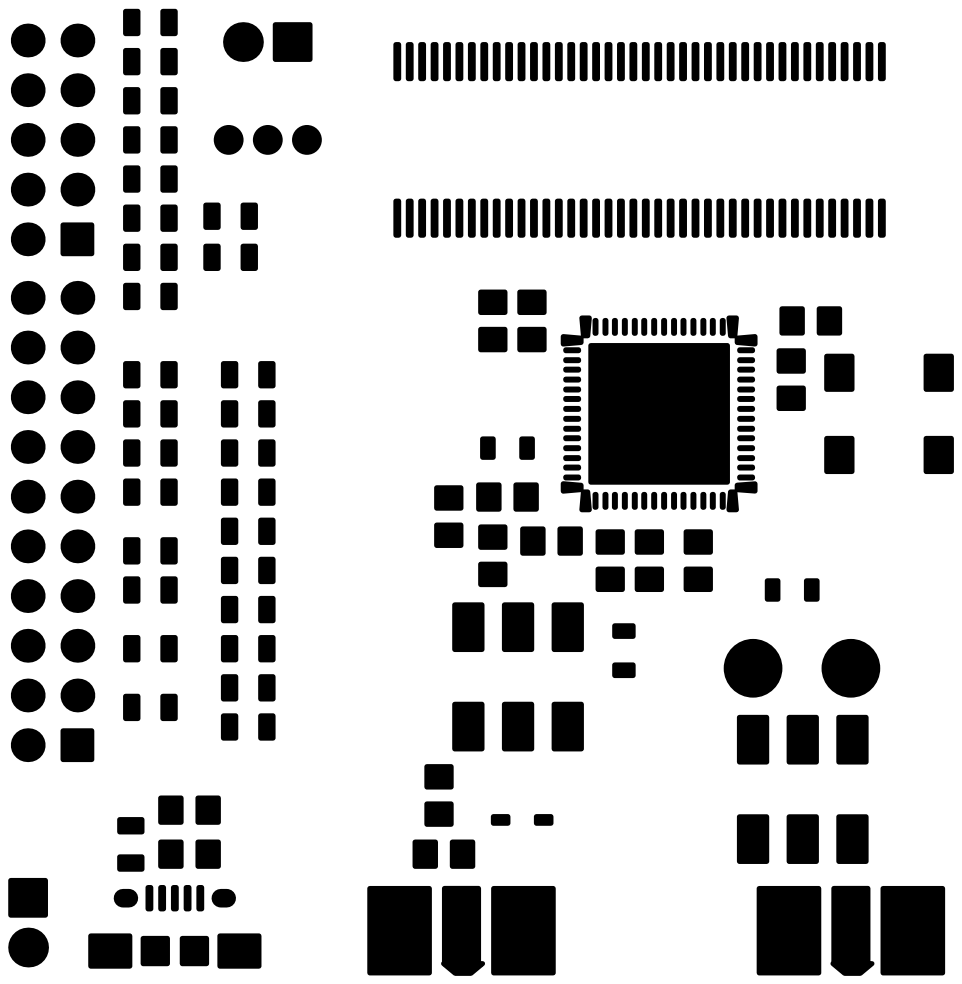
[picture p28: page 1]
