frohro/Hermes-Lite/pcb/ad9866_2-F_SilkS.pdf

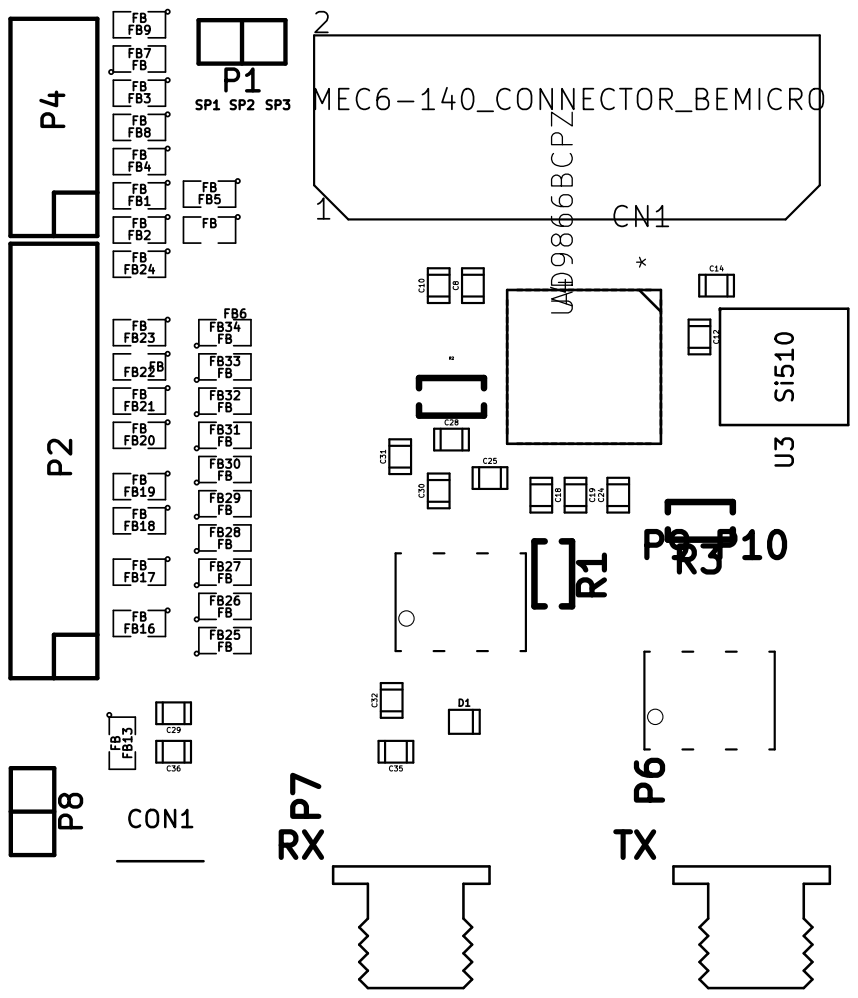
[picture p29: page 1]
