frohro/Hermes-Lite/pcb/ad9866_2-Inner1_Cu.pdf

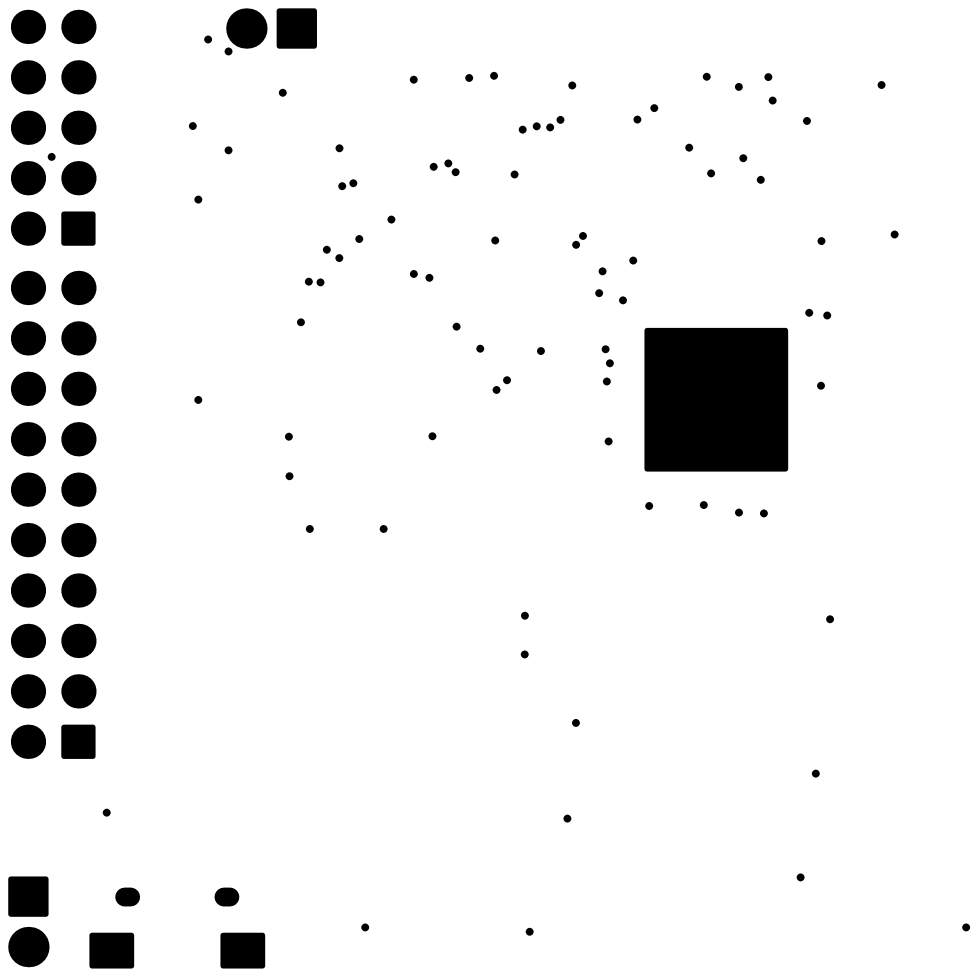
[picture p30: page 1]
