frohro/Hermes-Lite/pcb/ad9866_2-Inner2_Cu.pdf

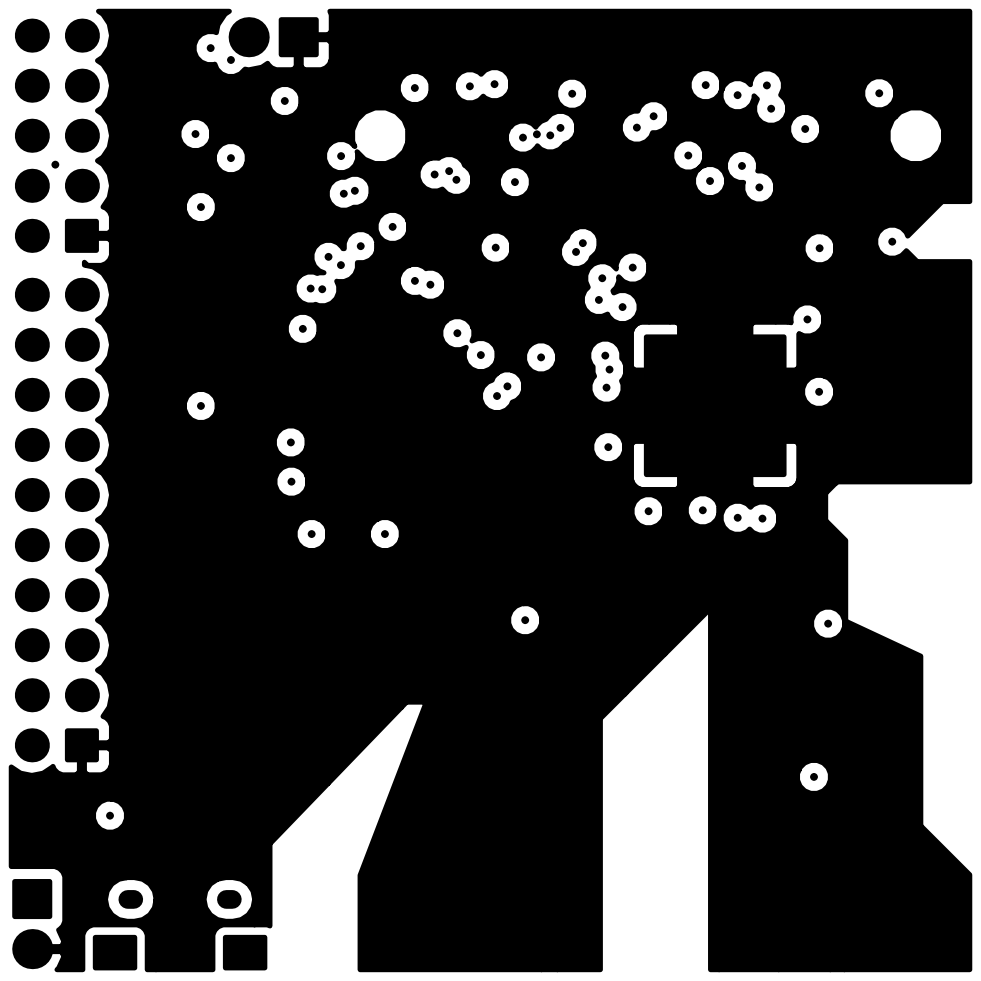
[picture p31: page 1]
