frohro/Hermes-Lite/pcb/PDF Plots/ad9866_2-B_Cu.pdf

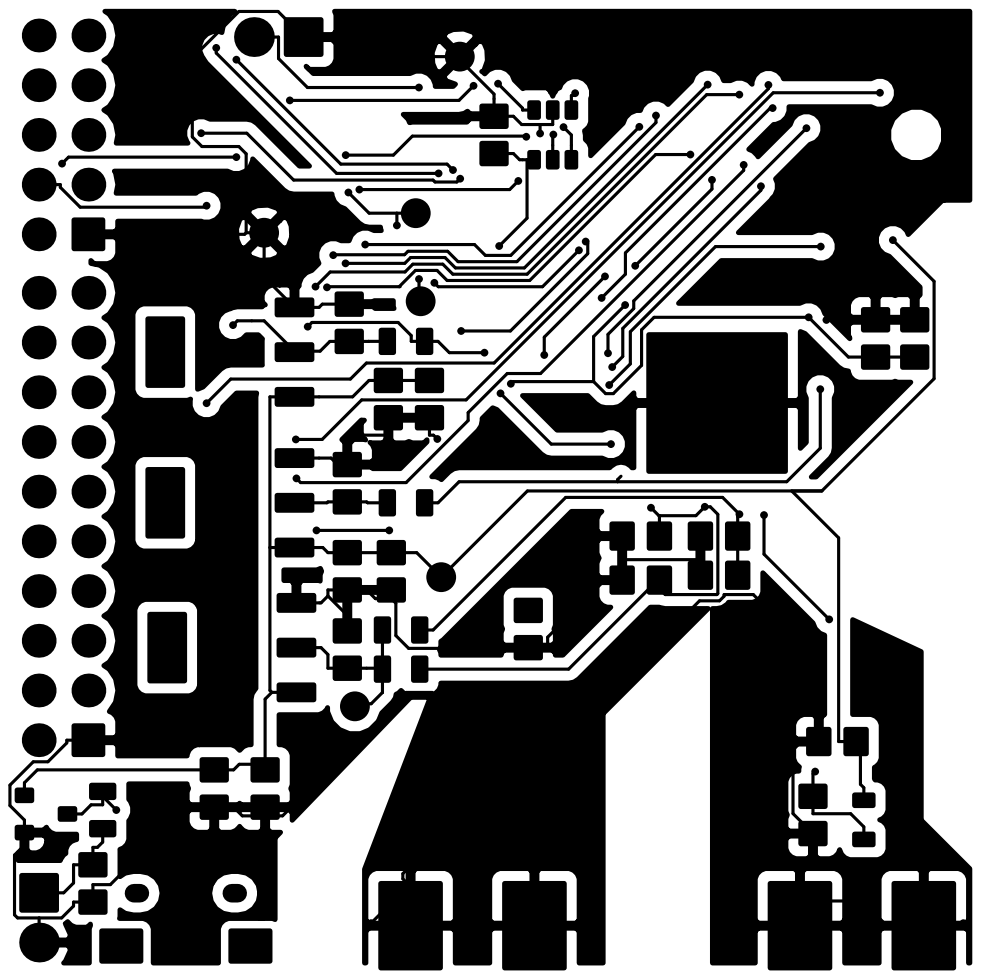
[picture p32: page 1]
