frohro/Hermes-Lite/pcb/PDF Plots/ad9866_2-B_Mask.pdf

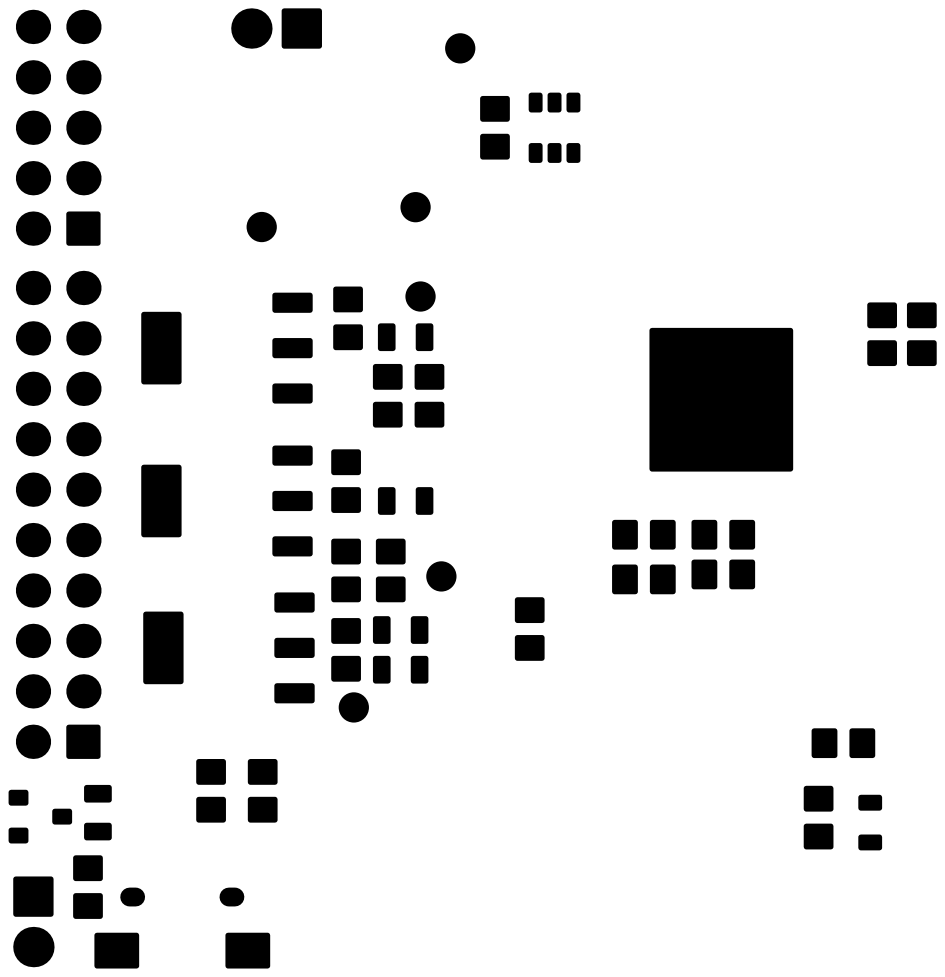
[picture p33: page 1]
