frohro/Hermes-Lite/pcb/PDF Plots/ad9866_2-B_Paste.pdf

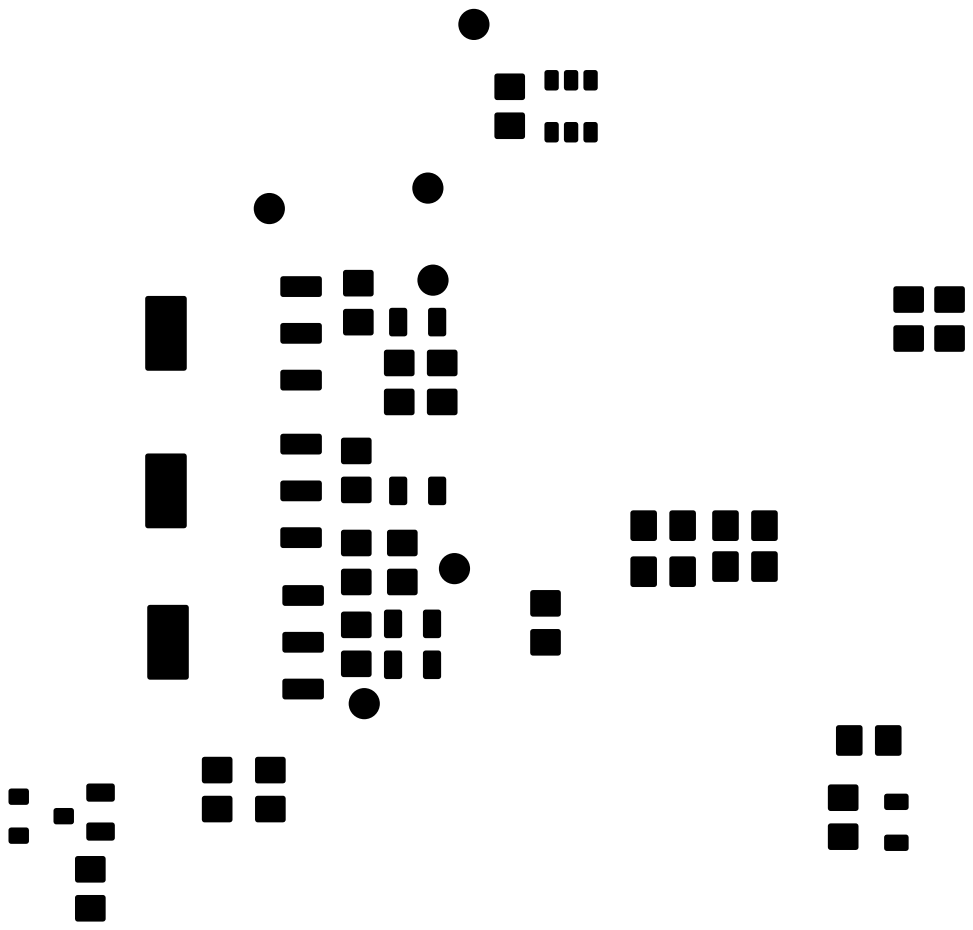
[picture p34: page 1]
