frohro/Hermes-Lite/pcb/PDF Plots/ad9866_2-B_SilkS.pdf

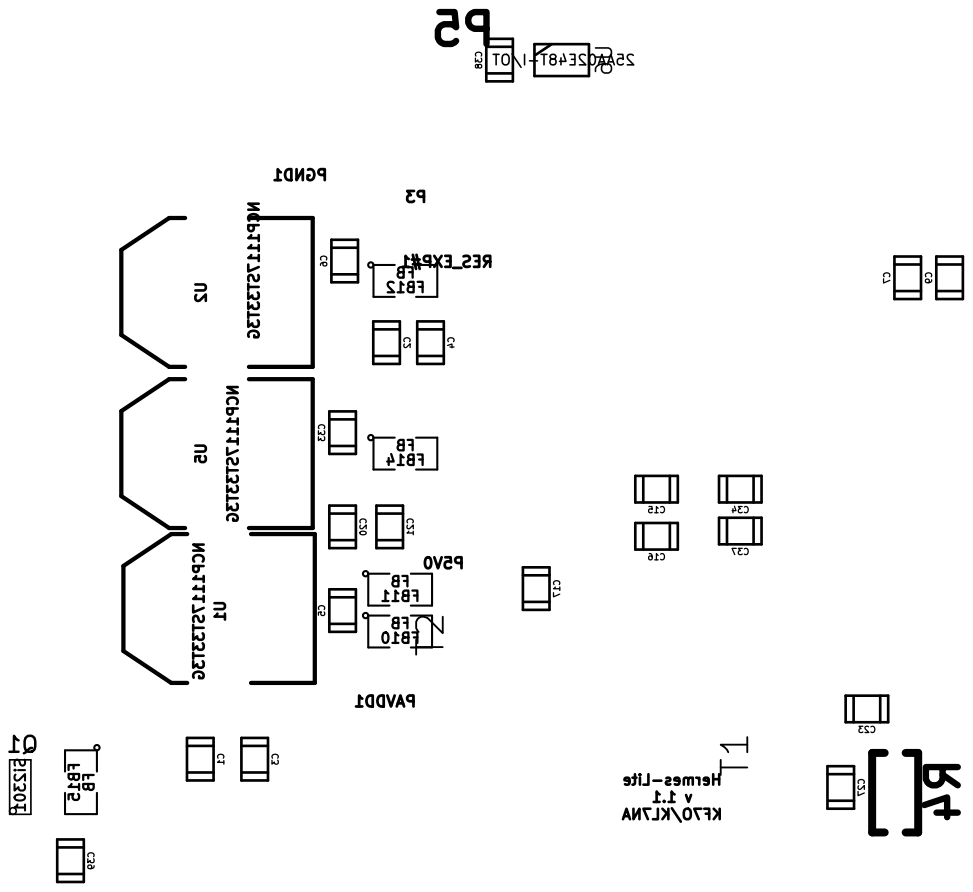
[picture p35: page 1]
