frohro/Hermes-Lite/pcb/PDF Plots/ad9866_2-F_Cu.pdf

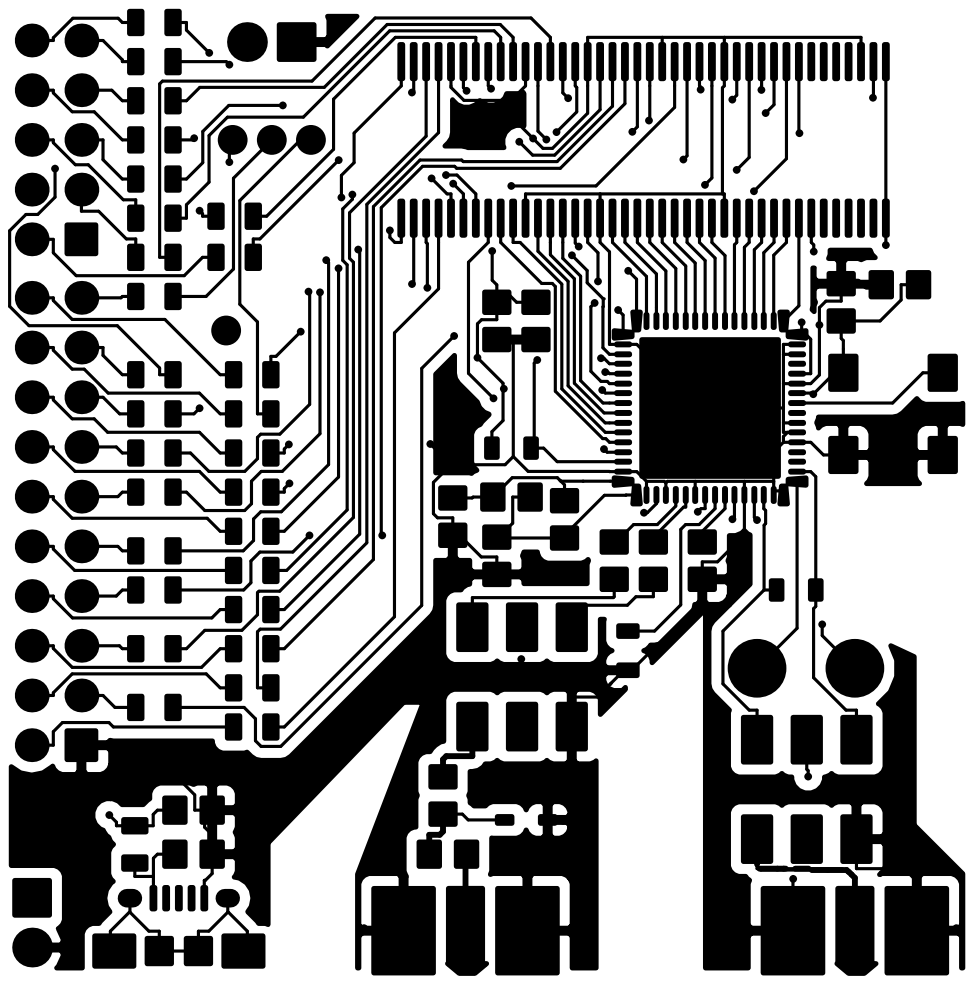
[picture p36: page 1]
