frohro/Hermes-Lite/pcb/PDF Plots/ad9866_2-F_Mask.pdf

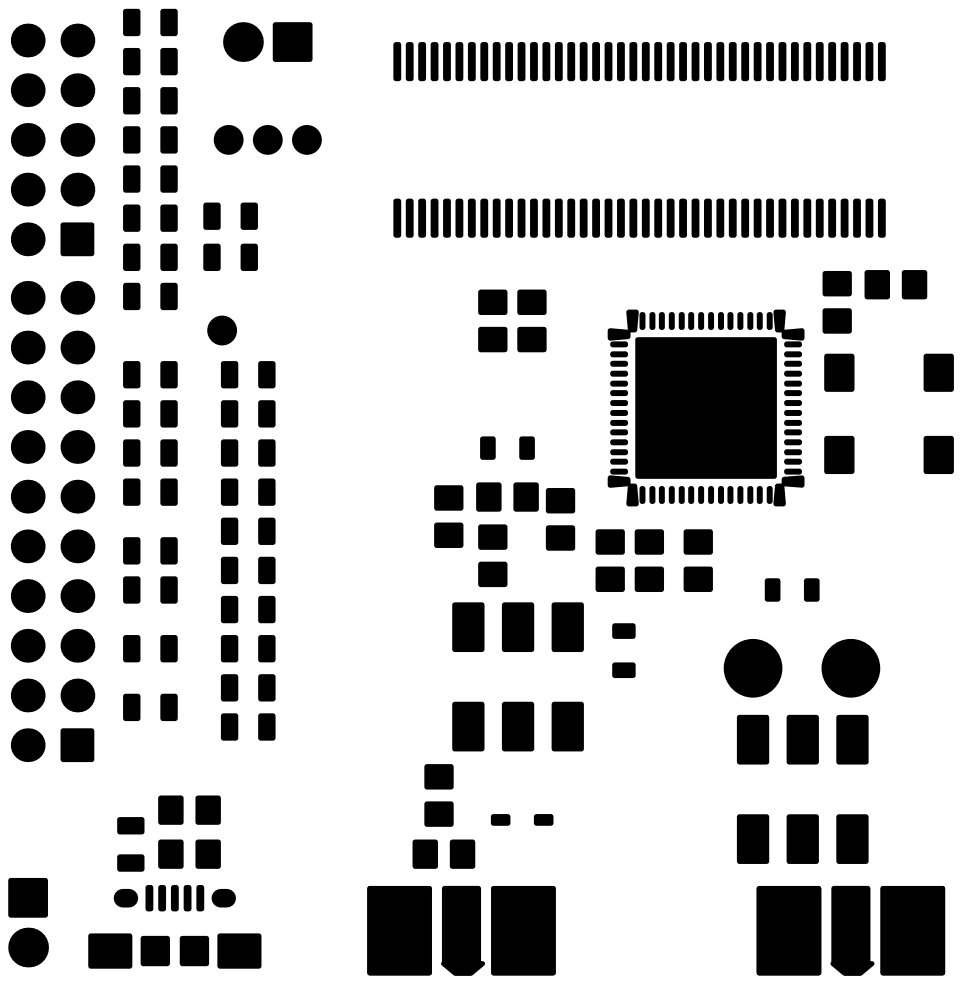
[picture p37: page 1]
