frohro/Hermes-Lite/pcb/PDF Plots/ad9866_2-F_Paste.pdf

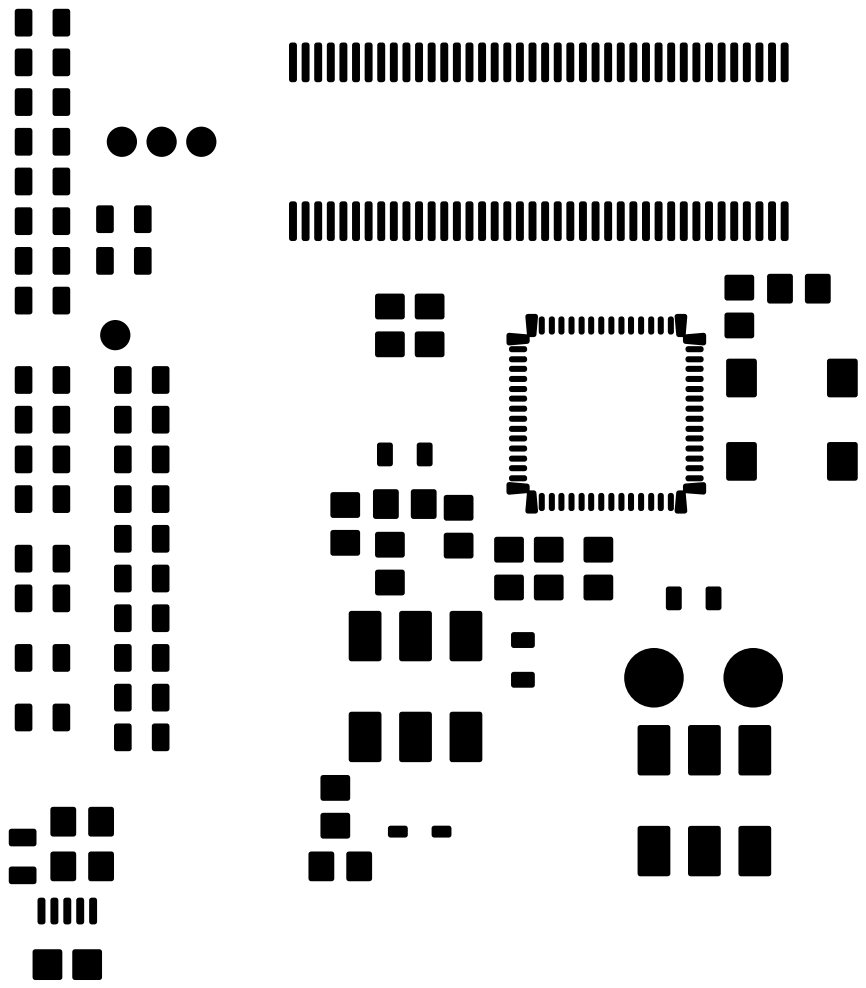
[picture p38: page 1]
