frohro/Hermes-Lite/pcb/PDF Plots/ad9866_2-F_SilkS.pdf

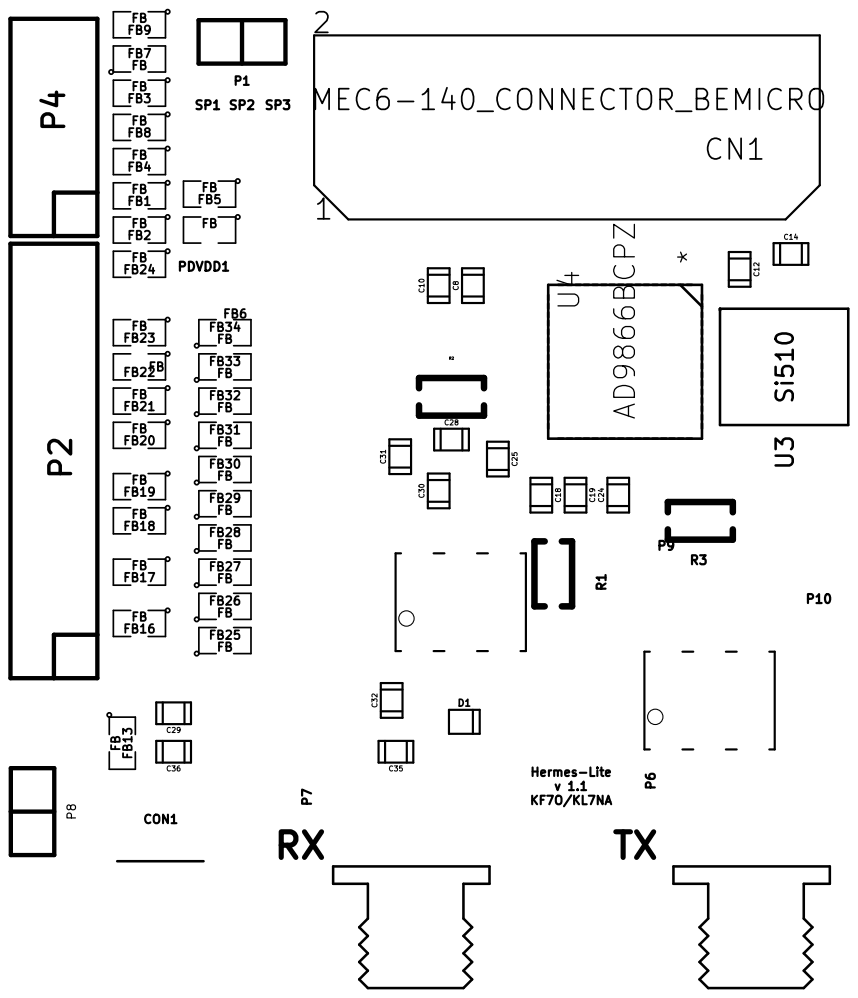
[picture p39: page 1]
