frohro/Hermes-Lite/pcb/PDF Plots/ad9866_2-Inner1_Cu.pdf

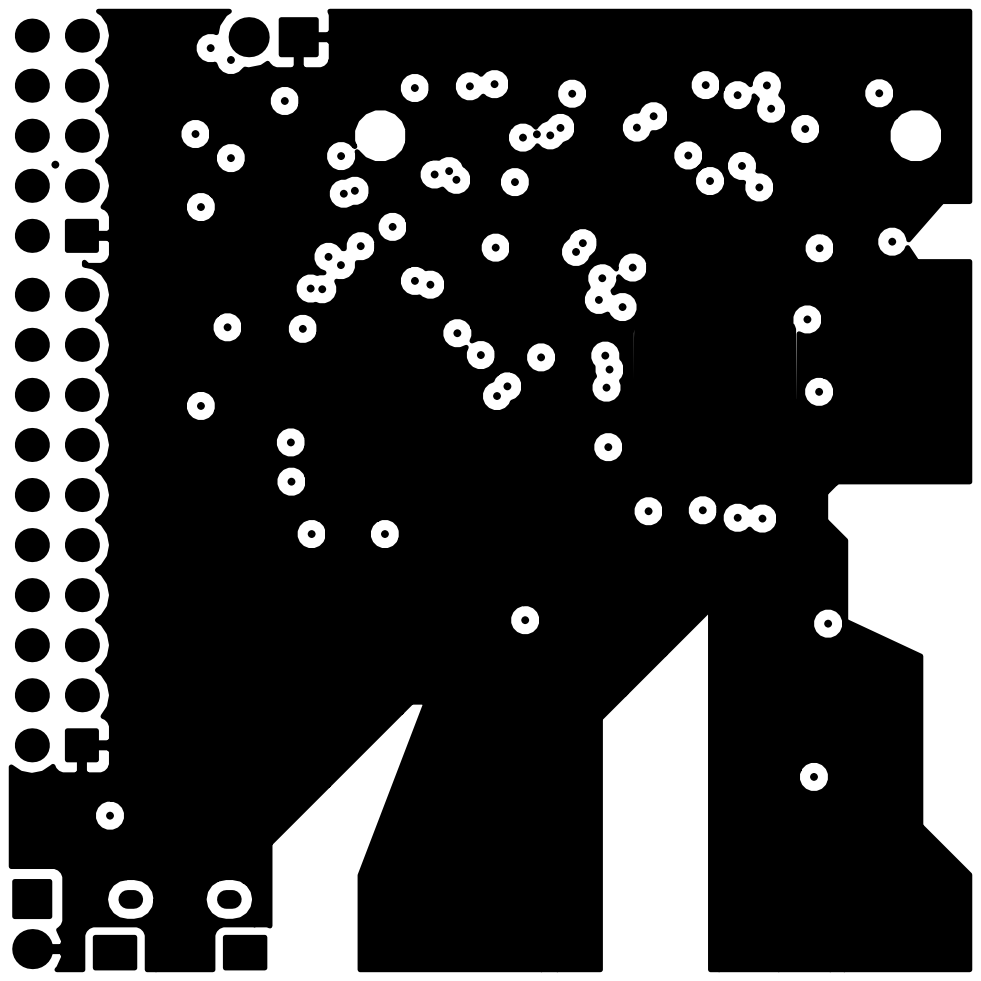
[picture p40: page 1]
