frohro/Hermes-Lite/pcb/PDF Plots/ad9866_2-Inner2_Cu.pdf

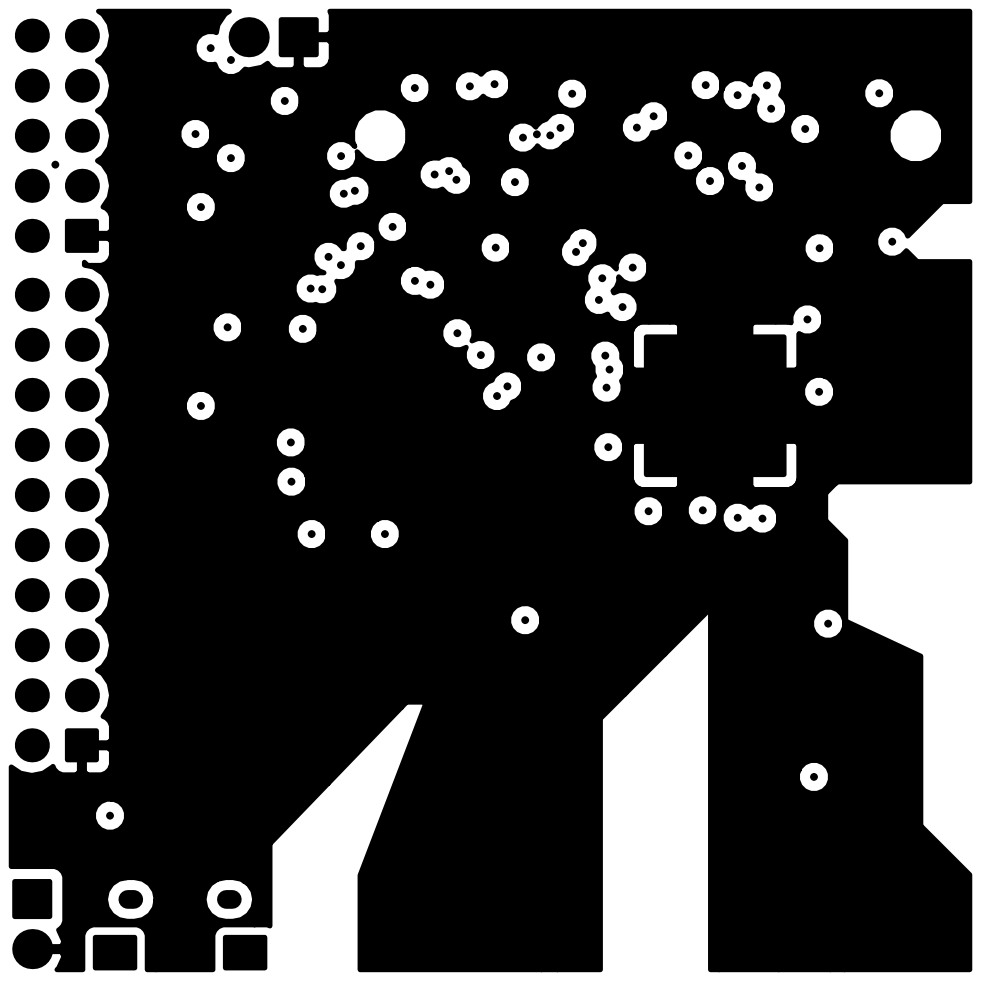
[picture p41: page 1]
