frohro/Hermes-Lite/pcb/old/ad9866_2.pdf

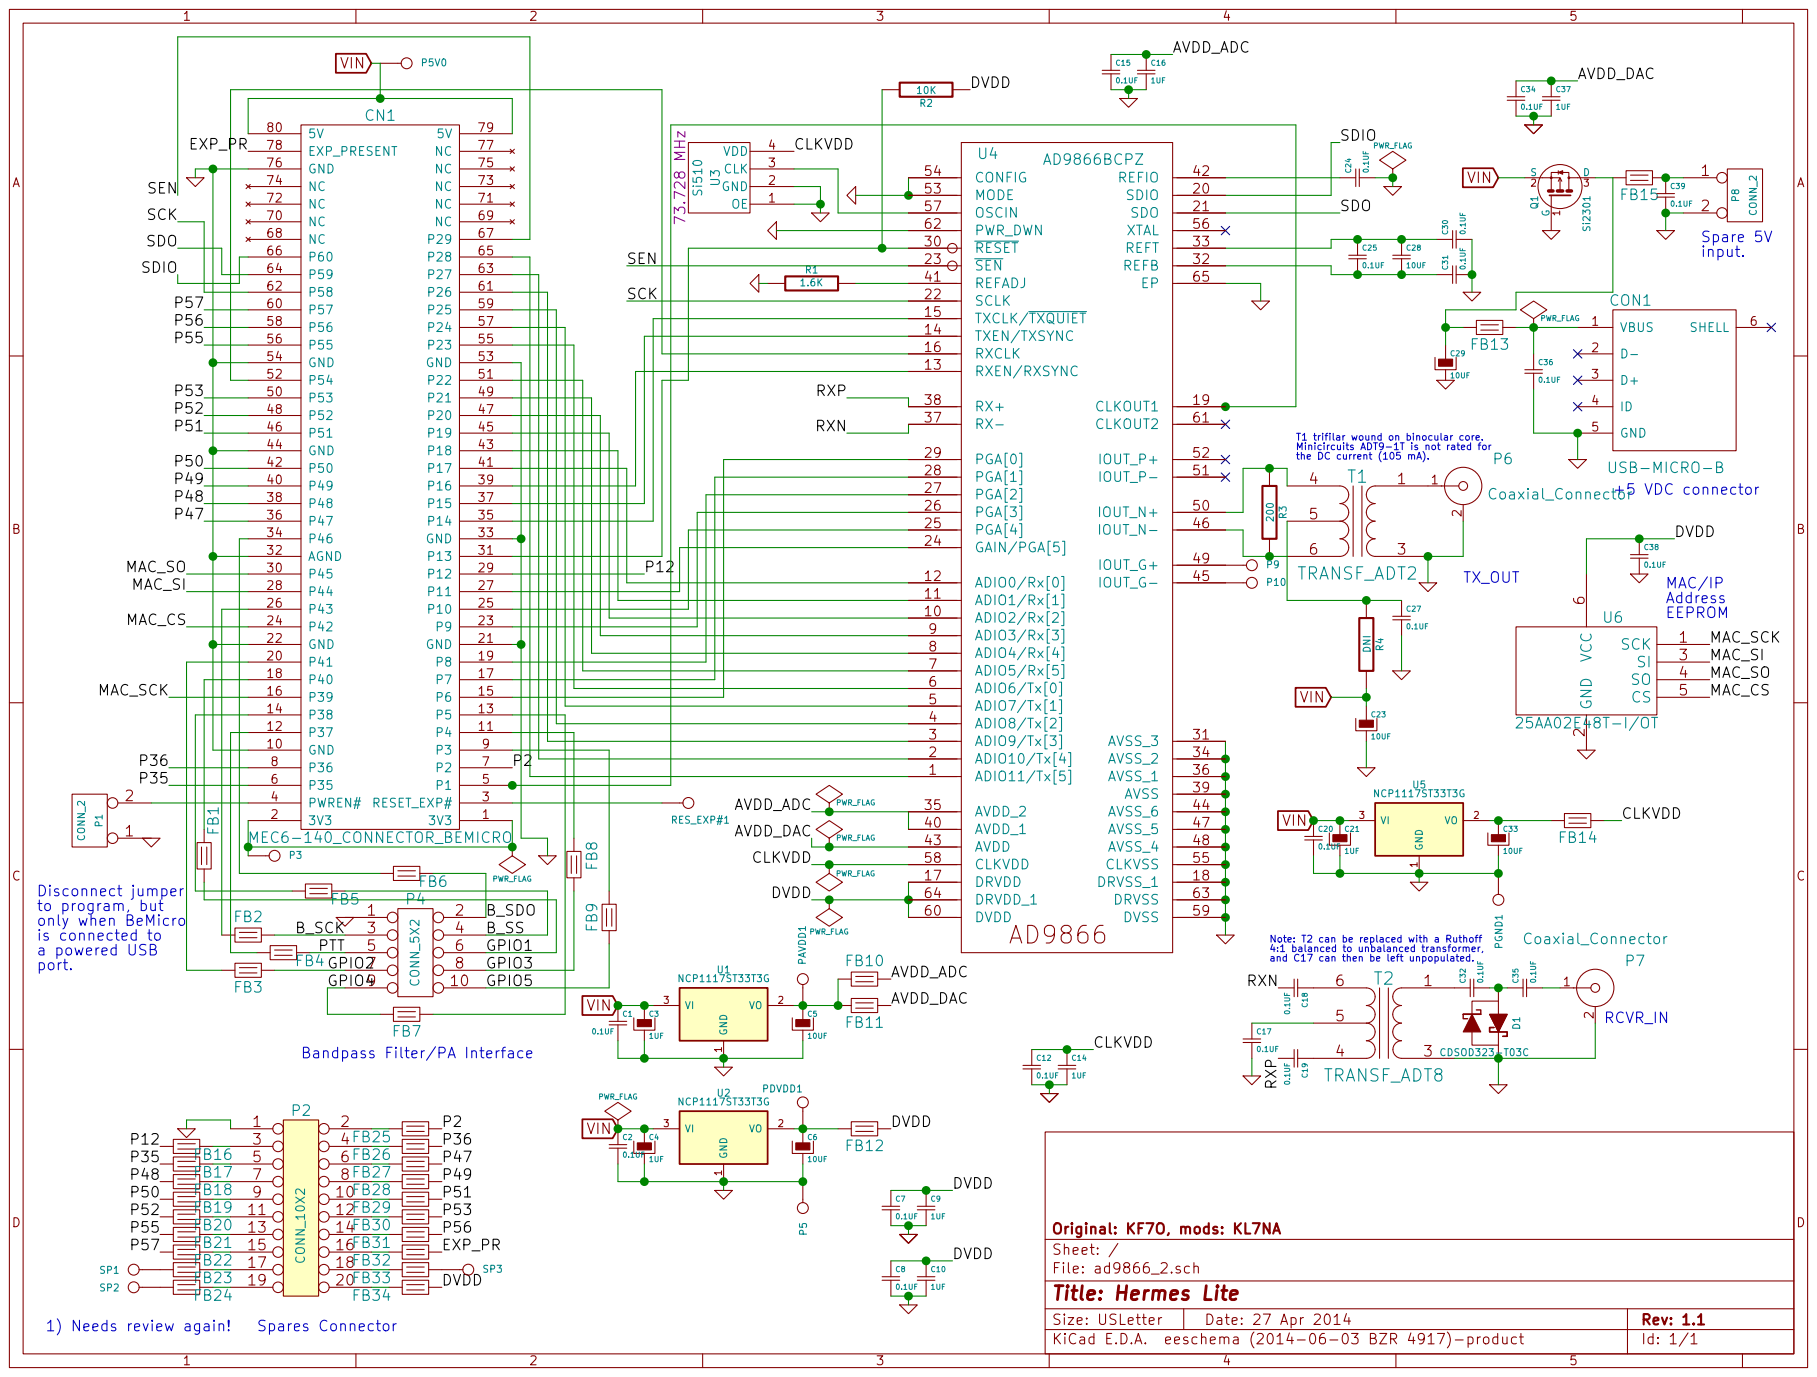
[picture p42: page 1]

T1 trifilar wound on binocular core. Minicircuits ADT9-1T is not rated for

MAC/IP Address EEPROM

2 SCK 1 SI 3 SO 4 CS 5 VCC

Disconnect jumper
to program, but
only when BeMicro
is connected to a powered USB

GPIO2 | 7 | | 8

Note: T2 can be replaced with a Ruthoff 4:1 balanced to unbalanced transformer, and C17 can then be left unpopulated.

Bandpass Filter/PA Interface

9 | 10
11 | 12
13 | 14

File: ad9866_2.sch Sheet: / Original: KF7O, mods: KL7NA

Id: 1/1 Title: Hermes Lite
