frohro/Hermes-Lite/(list of files, drawings)

Other design files:
pcb/ad9866_2.dsn
pcb/old/ad9866_2.dsn
