frohro/Hermes-Lite/pcb/ad9866.kicad_pcb

## KiCad design pcb/ad9866.kicad_pcb (2014-07-15)

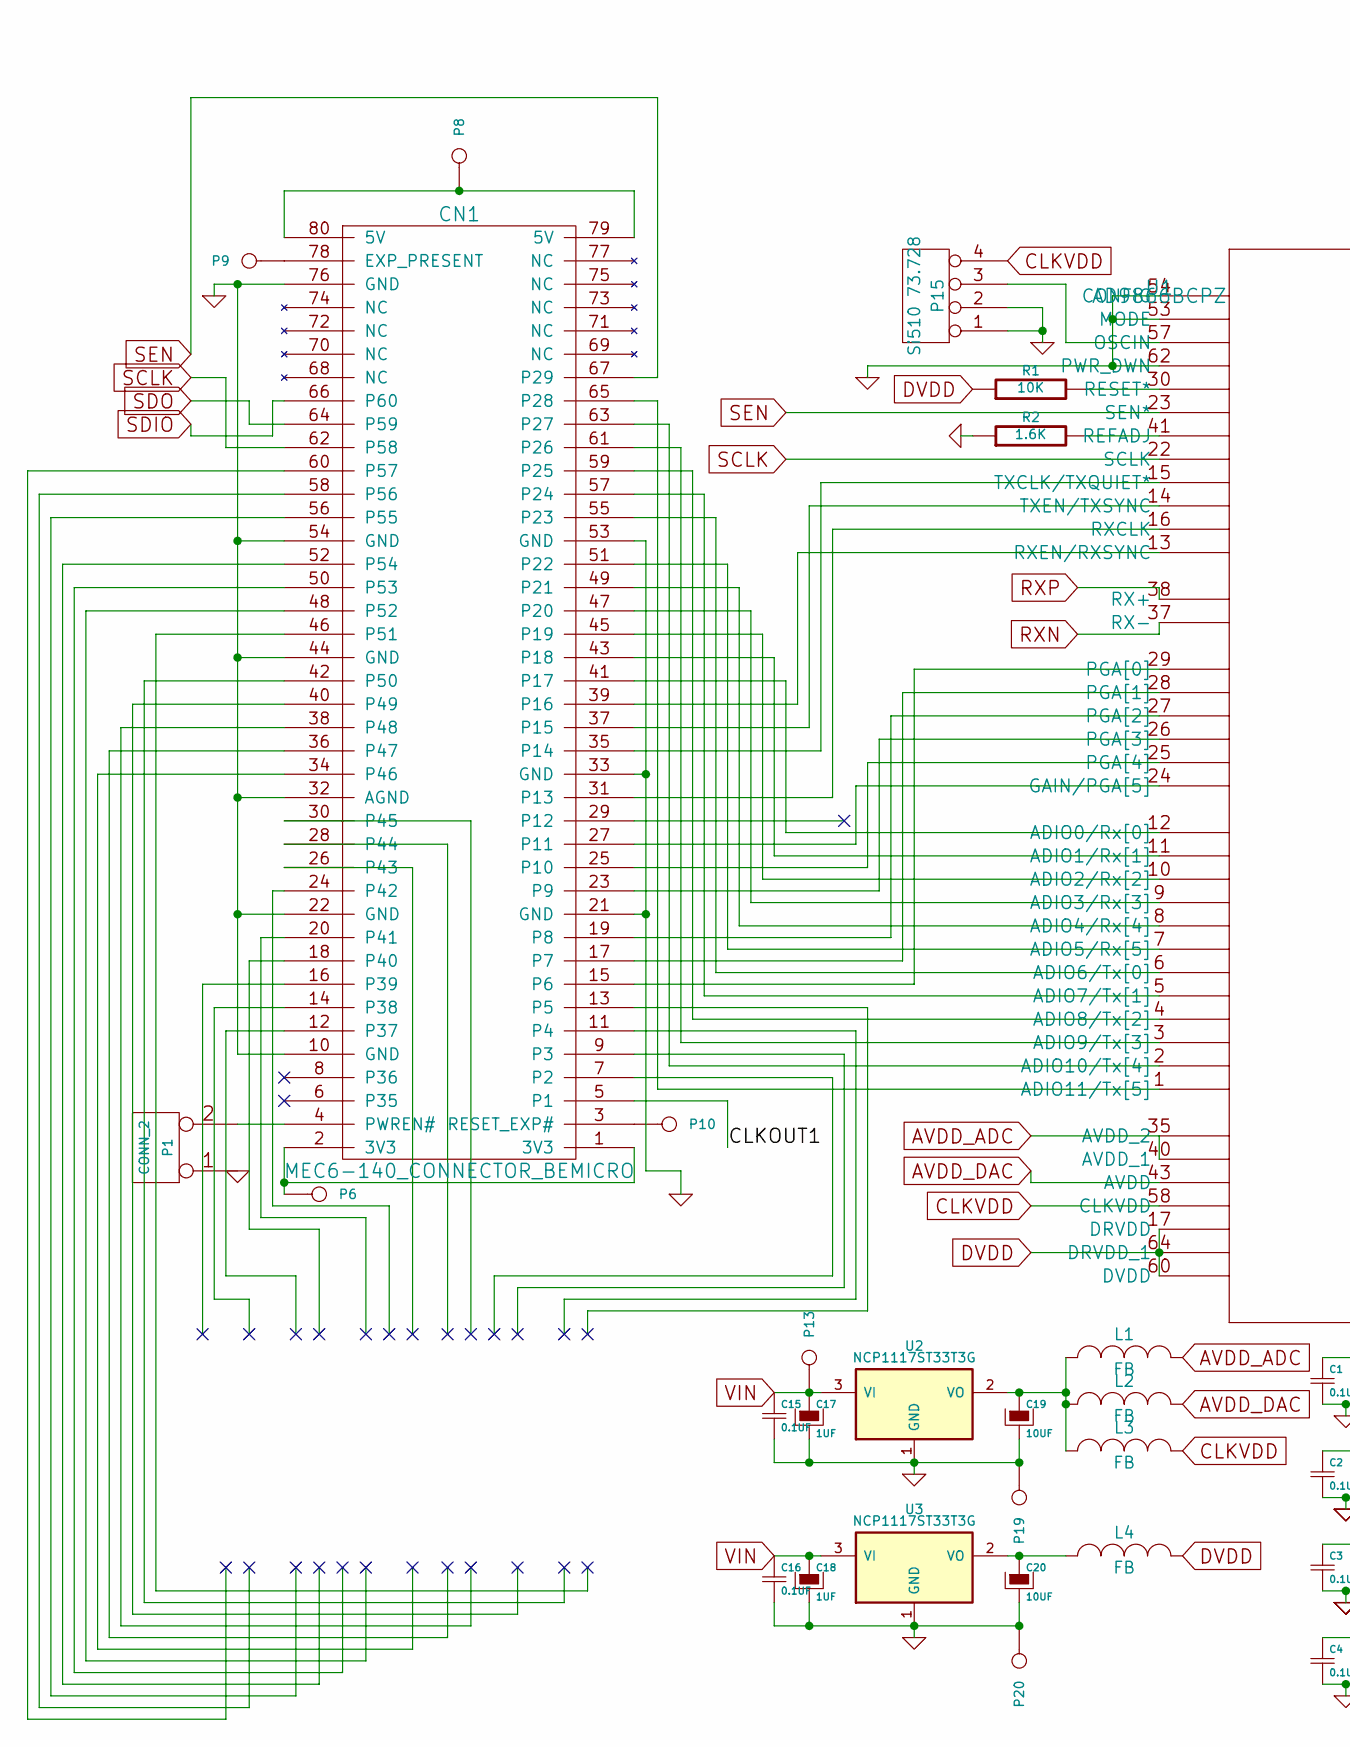
[picture p43: schematic ad9866.sch, part in row 1, column 1]

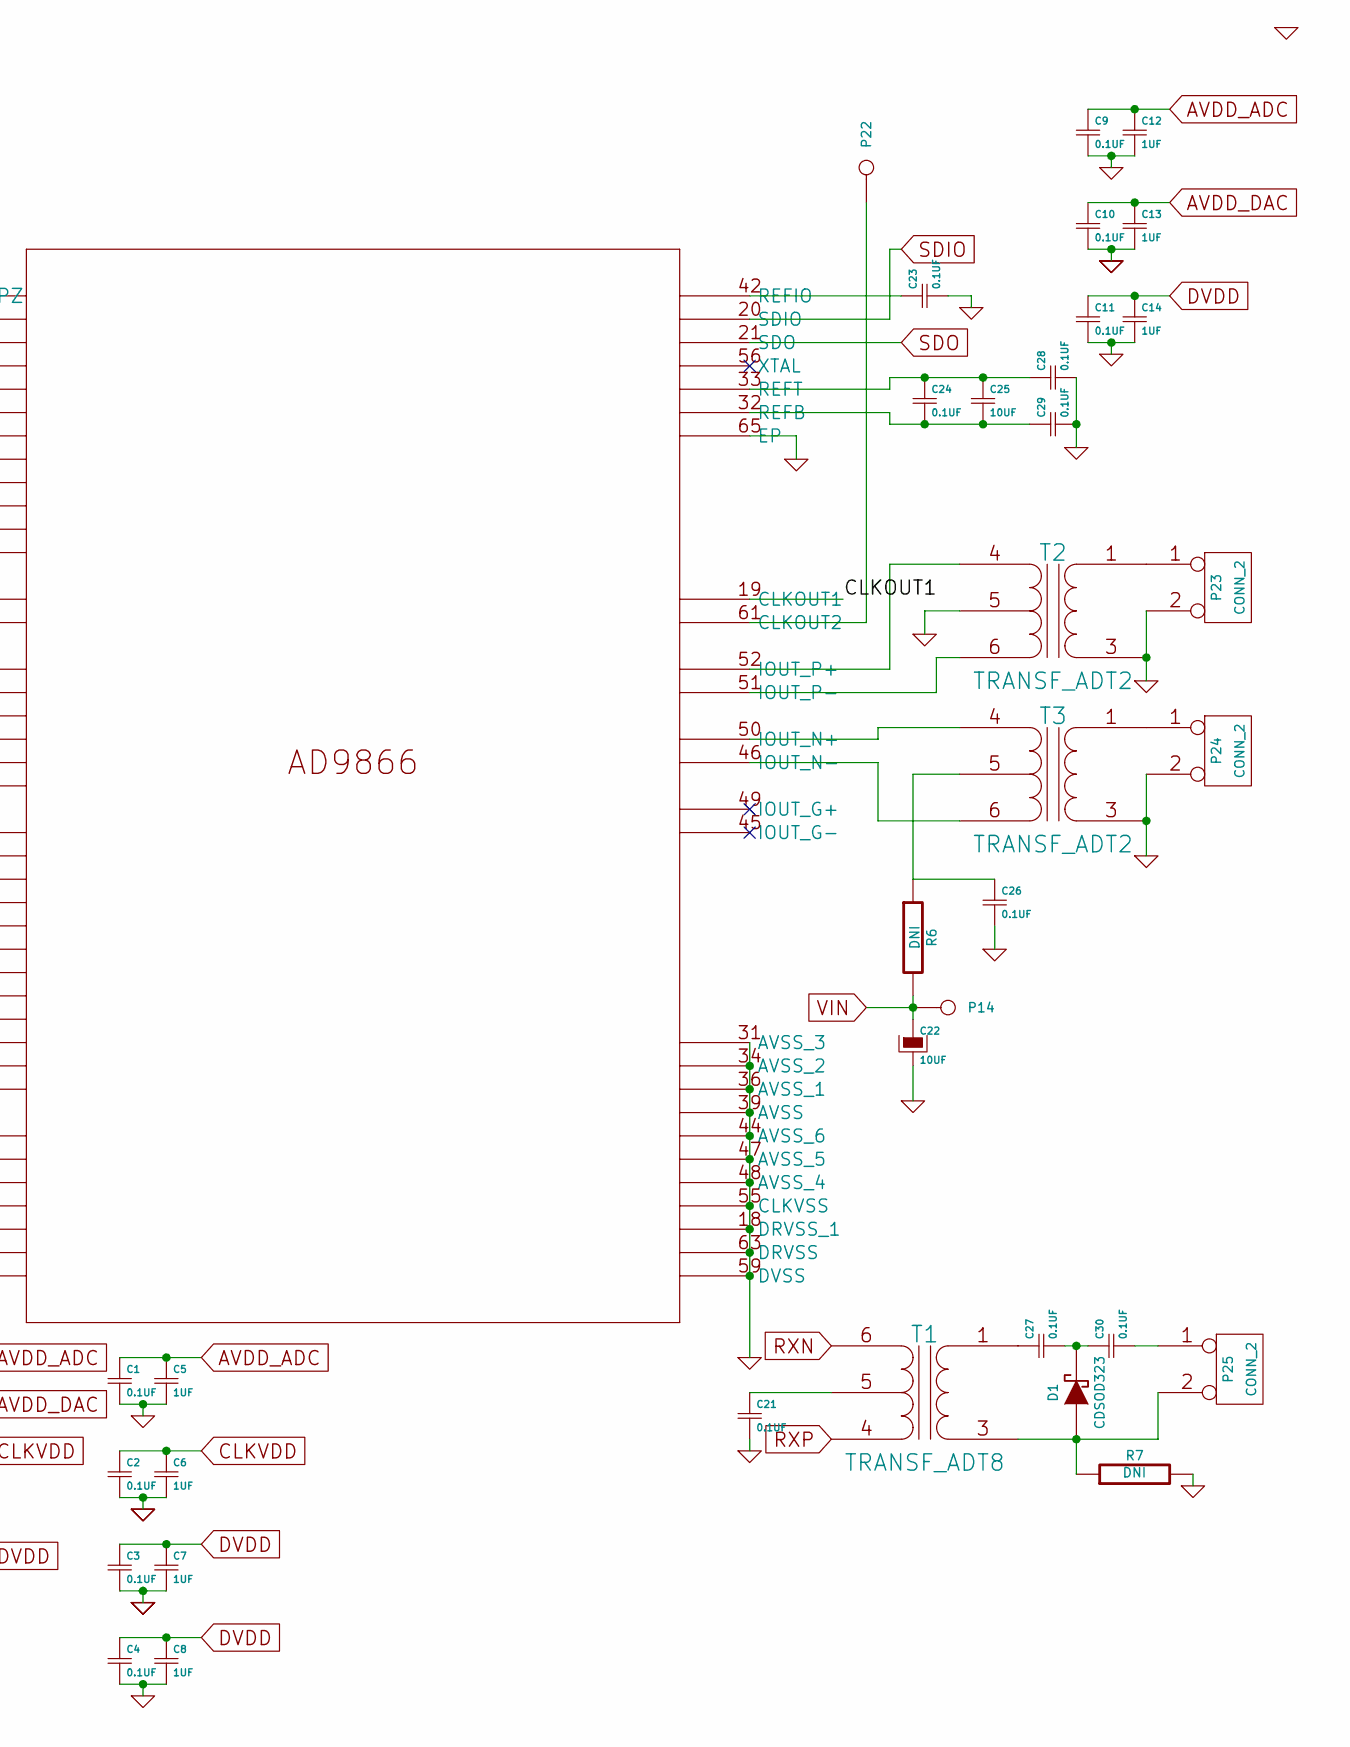
[picture p44: schematic ad9866.sch, part in row 1, column 2]

Parts:
C1, C2, C3, C4, C9, C10, C11, C15, C16, C21, C23, C24, C26, C27, C28, C29, C30: 0.1UF
C5, C6, C7, C8, C12, C13, C14, C17, C18: 1UF
C19, C20, C22, C25: 10UF
CN1: MEC6-140_CONNECTOR_BEMICRO
D1: CDSOD323
L1, L2, L3, L4: FB
P1, P23, P24, P25: CONN_2
P6, P8, P9, P10, P13, P14, P19, P20, P22: CONN_1
P15: Si510 73.728
R1: 10K
R2: 1.6K
R6, R7: DNI
T1: TRANSF_ADT8
T2, T3: TRANSF_ADT2
U1: AD9866BCPZ
U2, U3: NCP1117ST33T3G

Connections:
/CLKOUT1: CN1.5 (P1), U1.19 (CLKOUT1)
AVDD_ADC: C1.1, C5.1, C9.1, C12.1, L1.2, U1.35 (AVDD_2), U1.40 (AVDD_1)
AVDD_DAC: C10.1, C13.1, L2.2, U1.43 (AVDD)
CLKVDD: C2.1, C6.1, L3.2, P15.4, U1.58 (CLKVDD)
DVDD: C3.1, C4.1, C7.1, C8.1, C11.1, C14.1, L4.2, R1.1, U1.17 (DRVDD), U1.60 (DVDD), U1.64 (DRVDD_1)
GND: C1.2, C2.2, C3.2, C4.2, C5.2, C6.2, C7.2, C8.2, C9.2, C10.2, C11.2, C12.2, C13.2, C14.2, C15.2, C16.2, C17.2, C18.2, C19.2, C20.2, C21.2, C22.2, C23.2, C26.2, C28.2, C29.2, CN1.10 (GND), CN1.21 (GND), CN1.22 (GND), CN1.32 (AGND), CN1.33 (GND), CN1.44 (GND), CN1.53 (GND), CN1.54 (GND), CN1.76 (GND), P1.1, P15.1, P15.2, P19.1, P20.1, P23.2 (PM), P24.2 (PM), R2.1, R7.2, T2.3 (S1), T2.5 (PM), T3.3 (S1), U1.18 (DRVSS_1), U1.31 (AVSS_3), U1.34 (AVSS_2), U1.36 (AVSS_1), U1.39 (AVSS), U1.44 (AVSS_6), U1.47 (AVSS_5), U1.48 (AVSS_4), U1.53 (MODE), U1.54 (CONFIG), U1.55 (CLKVSS), U1.59 (DVSS), U1.62 (PWR_DWN), U1.63 (DRVSS), U1.65 (EP), U2.1 (GND), U3.1 (GND)
unnamed: C19.1, L1.1, L2.1, L3.1, U2.2 (VO)
unnamed: C20.1, L4.1, U3.2 (VO)
unnamed: C21.1, T1.5 (PM)
unnamed: C23.1, U1.42 (REFIO)
unnamed: C24.1, C25.1, C28.1, U1.33 (REFT)
unnamed: C24.2, C25.2, C29.1, U1.32 (REFB)
unnamed: C26.1, R6.1, T3.5 (PM)
unnamed: C27.1, T1.1 (S2)
unnamed: C27.2, C30.1, D1.2 (K)
unnamed: C30.2, P25.1
unnamed: CN1.1 (3V3), CN1.2 (3V3), P6.1
unnamed: CN1.3 (RESET_EXP#), P10.1
unnamed: CN1.4 (PWREN#), P1.2 (PM)
unnamed: CN1.15 (P6), U1.29 (PGA[0])
unnamed: CN1.17 (P7), U1.28 (PGA[1])
unnamed: CN1.19 (P8), U1.27 (PGA[2])
unnamed: CN1.23 (P9), U1.26 (PGA[3])
unnamed: CN1.25 (P10), U1.25 (PGA[4])
unnamed: CN1.27 (P11), U1.24 (GAIN/PGA[5])
unnamed: CN1.31 (P13), U1.16 (RXCLK)
unnamed: CN1.35 (P14), U1.15 (TXCLK/TXQUIET*)
unnamed: CN1.37 (P15), U1.14 (TXEN/TXSYNC)
unnamed: CN1.39 (P16), U1.13 (RXEN/RXSYNC)
unnamed: CN1.41 (P17), U1.12 (ADIO0/Rx[0])
unnamed: CN1.43 (P18), U1.11 (ADIO1/Rx[1])
unnamed: CN1.45 (P19), U1.10 (ADIO2/Rx[2])
unnamed: CN1.47 (P20), U1.9 (ADIO3/Rx[3])
unnamed: CN1.49 (P21), U1.8 (ADIO4/Rx[4])
unnamed: CN1.51 (P22), U1.7 (ADIO5/Rx[5])
unnamed: CN1.55 (P23), U1.6 (ADIO6/Tx[0])
unnamed: CN1.57 (P24), U1.5 (ADIO7/Tx[1])
unnamed: CN1.59 (P25), U1.4 (ADIO8/Tx[2])
unnamed: CN1.61 (P26), U1.3 (ADIO9/Tx[3])
unnamed: CN1.63 (P27), U1.2 (ADIO10/Tx[4])
unnamed: CN1.65 (P28), U1.1 (ADIO11/Tx[5])
unnamed: CN1.78 (EXP_PRESENT), P9.1
unnamed: CN1.79 (5V), CN1.80 (5V), P8.1
unnamed: D1.1 (A), P25.2 (PM), R7.1, T1.3 (S1)
unnamed: P15.3, U1.57 (OSCIN)
unnamed: P22.1, U1.61 (CLKOUT2)
unnamed: P23.1, T2.1 (S2)
unnamed: P24.1, T3.1 (S2)
unnamed: R1.2, U1.30 (RESET*)
unnamed: R2.2, U1.41 (REFADJ)
unnamed: T2.4 (PR1), U1.52 (IOUT_P+)
unnamed: T2.6 (PR2), U1.51 (IOUT_P-)
unnamed: T3.4 (PR1), U1.50 (IOUT_N+)
unnamed: T3.6 (PR2), U1.46 (IOUT_N-)
RXN: T1.6 (PR1), U1.37 (RX-)
RXP: T1.4 (PR2), U1.38 (RX+)
SCLK: CN1.62 (P58), U1.22 (SCLK)
SDIO: CN1.66 (P60), U1.20 (SDIO)
SDO: CN1.64 (P59), U1.21 (SDO)
SEN: CN1.67 (P29), U1.23 (SEN*)
VIN: C15.1, C16.1, C17.1, C18.1, C22.1, P13.1, P14.1, R6.2, U2.3 (VI), U3.3 (VI)

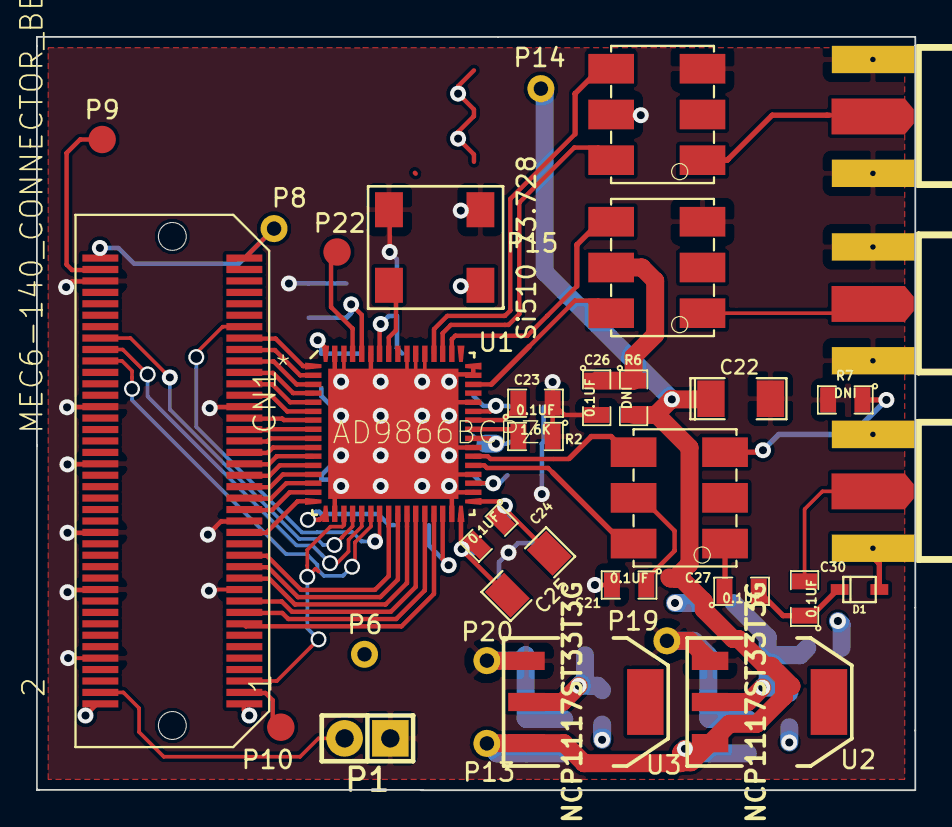
[picture p45: board ad9866.kicad_pcb from above]

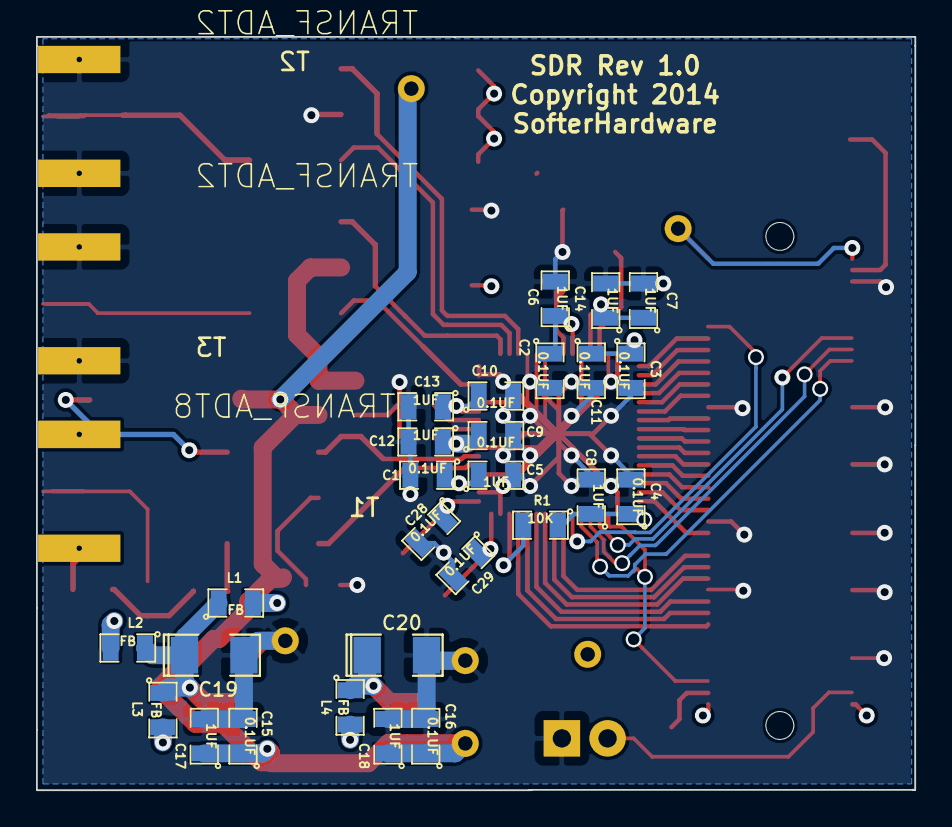
[picture p46: board ad9866.kicad_pcb from below]

Board: 4 copper layers, 48.8 x 41.8 mm, 60 parts (27 on the bottom side), 61 nets.
