frohro/Hermes-Lite/pcb/ad9866_2.kicad_pcb

## KiCad design pcb/ad9866_2.kicad_pcb (2014-06-25)

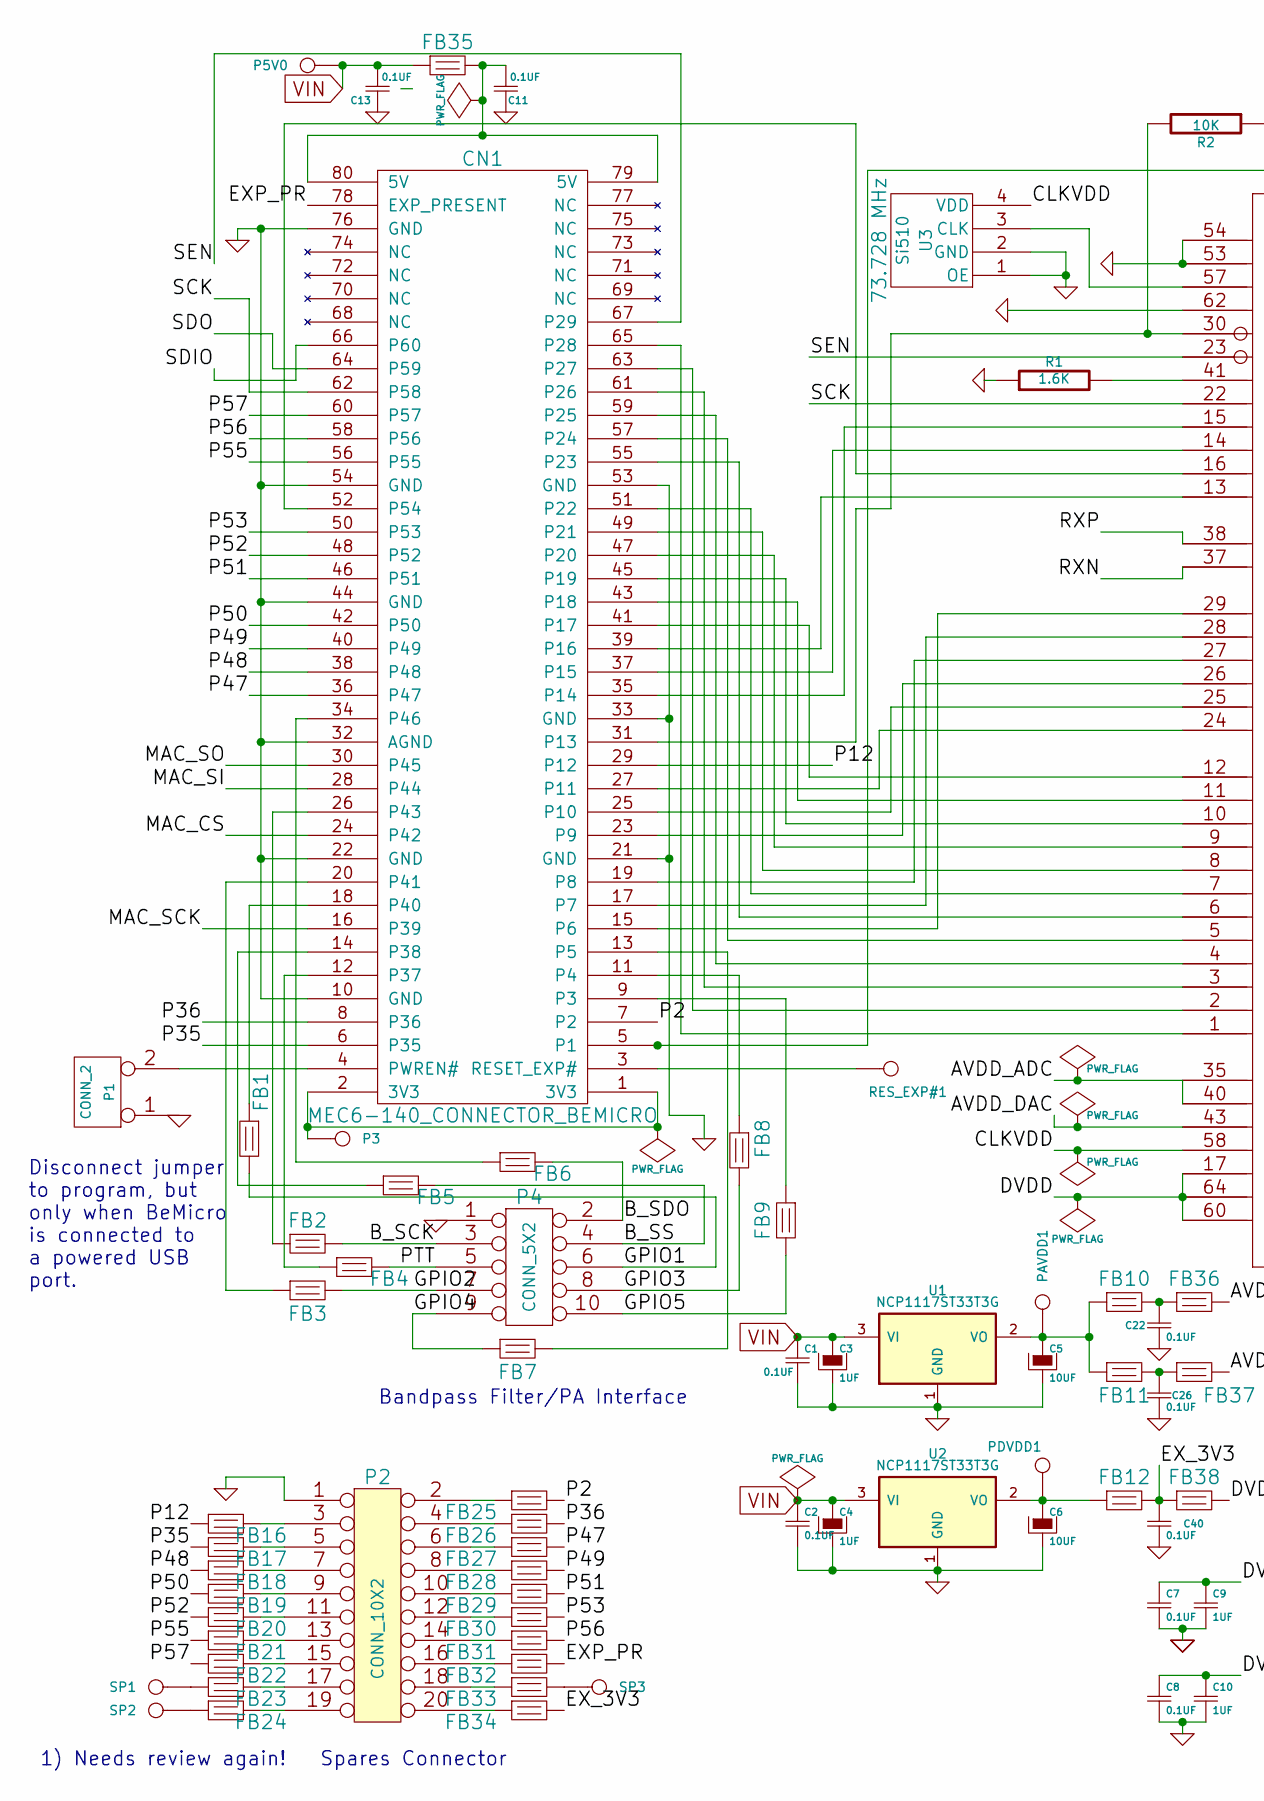
[picture p47: schematic ad9866_2.sch, Hermes Lite, part in row 1, column 1]

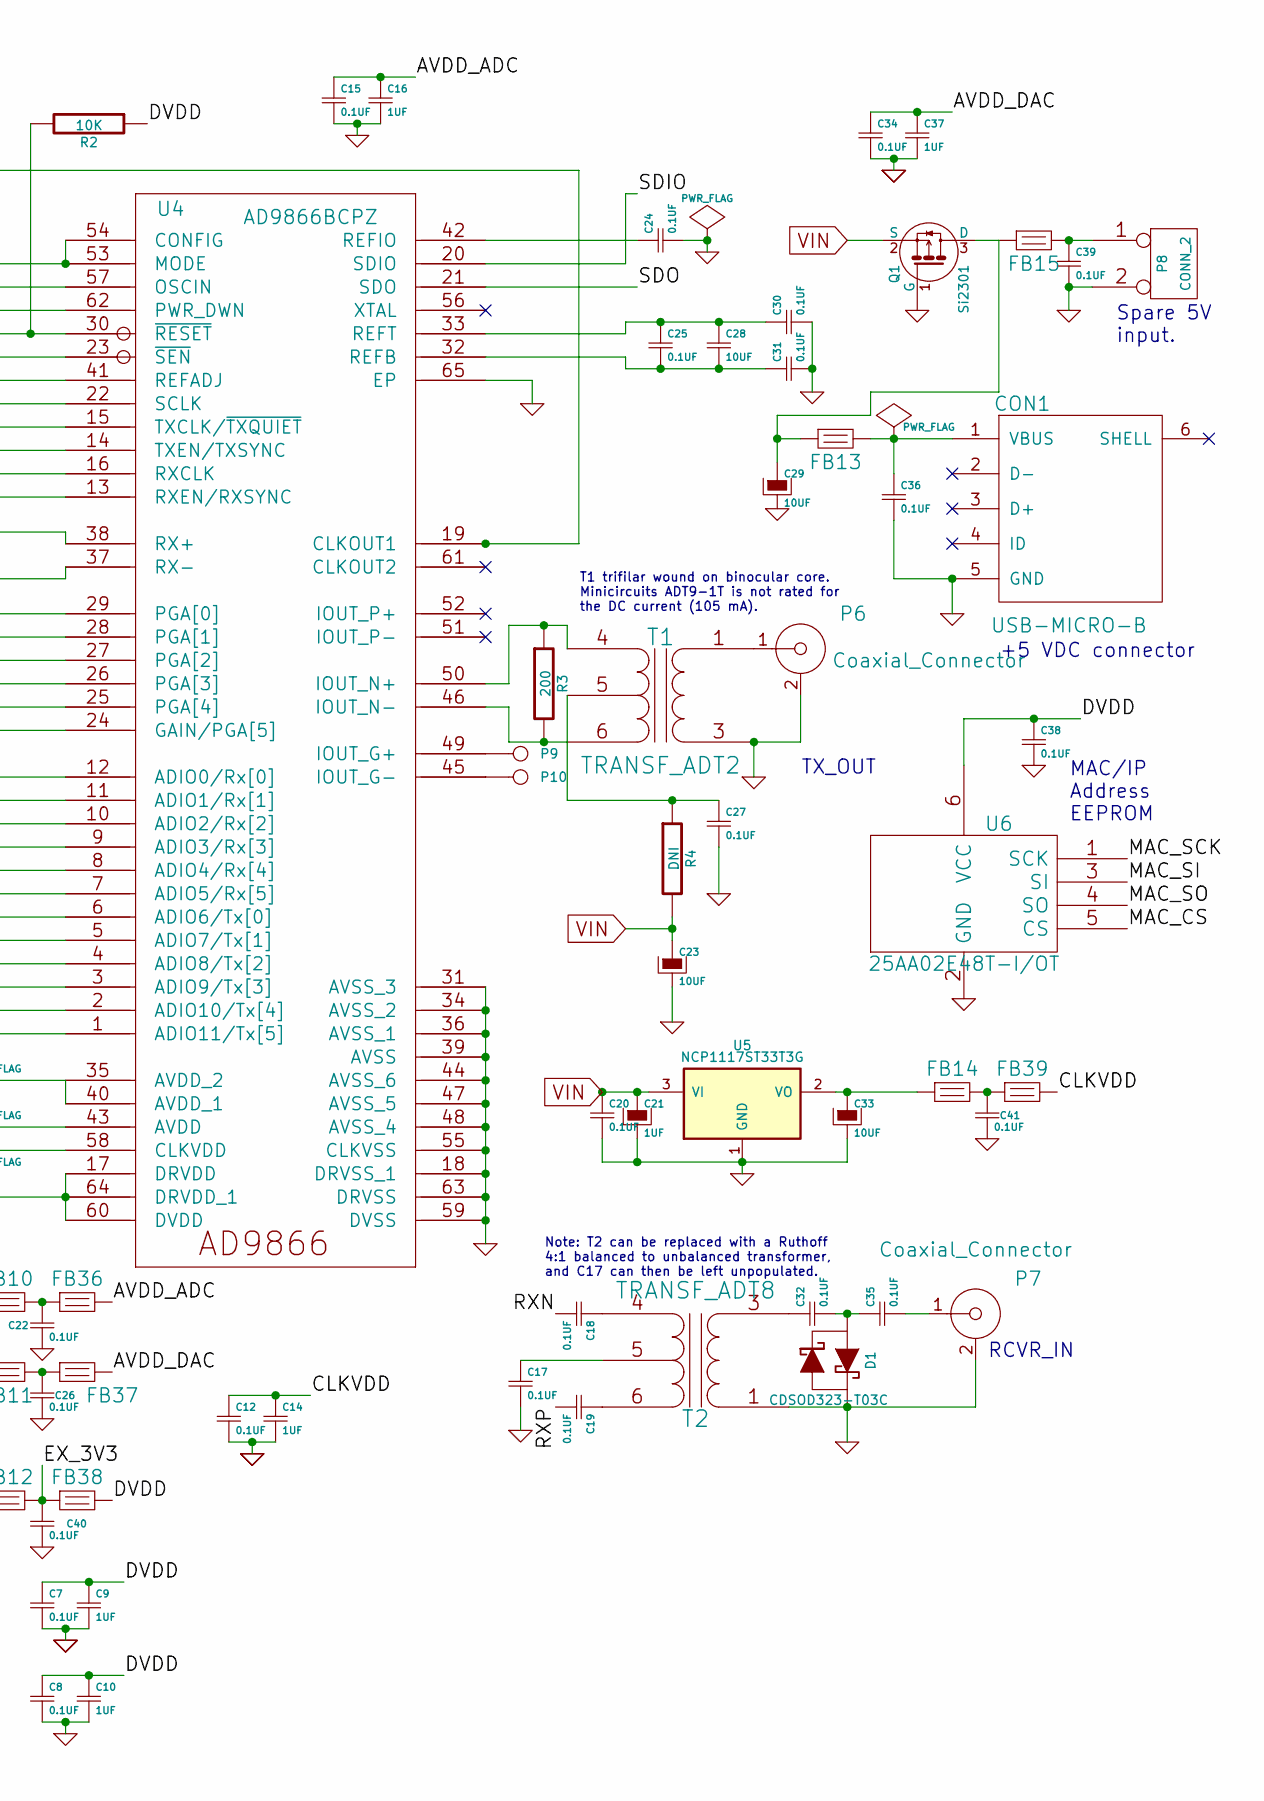
[picture p48: schematic ad9866_2.sch, Hermes Lite, part in row 1, column 2]

Parts:
C1, C2, C7, C8, C11, C12, C13, C15, C17, C18, C19, C20, C22, C24, C25, C26, C27, C30, C31, C32, C34, C35, C36, C38, C39, C40, C41: 0.1UF
C3, C4, C9, C10, C14, C16, C21, C37: 1UF
C5, C6, C23, C28, C29, C33: 10UF
CN1: MEC6-140_CONNECTOR_BEMICRO
CON1: USB-MICRO-B
D1: CDSOD323-T03C
FB1, FB2, FB3, FB4, FB5, FB6, FB7, FB8, FB9, FB10, FB11, FB12, FB13, FB14, FB15, FB16, FB17, FB18, FB19, FB20, FB21, FB22, FB23, FB24, FB25, FB26, FB27, FB28, FB29, FB30, FB31, FB32, FB33, FB34, FB35, FB36, FB37, FB38, FB39: FB
P1, P8: CONN_2
P2: CONN_10X2
P3, P5V0, P9, P10: CONN_1
P4: CONN_5X2
P6, P7: Coaxial_Connector
PAVDD1: CONN_1
PDVDD1: CONN_1
Q1: Si2301; SOT-23
R1: 1.6K
R2: 10K
R3: 200
R4: DNI
RES_EXP#1: CONN_1
SP1, SP2, SP3: CONN_1
T1: TRANSF_ADT2
T2: TRANSF_ADT8
U1, U2, U5: NCP1117ST33T3G
U3: Si510
U4: AD9866BCPZ
U6: 25AA02E48T-I/OT

Connections:
/AVDD_ADC: C15.1, C16.1, FB36.2, U4.35 (AVDD_2), U4.40 (AVDD_1)
/AVDD_DAC: C34.1, C37.1, FB37.2, U4.43 (AVDD)
/B_SCK: FB2.2, P4.3
/B_SDO: FB6.2, P4.2
/B_SS: FB5.2, P4.4
/CLKVDD: C12.1, C14.1, FB39.2, U3.4 (VDD), U4.58 (CLKVDD)
/DVDD: C7.1, C8.1, C9.1, C10.1, C38.1, FB38.2, R2.1, U4.17 (DRVDD), U4.60 (DVDD), U4.64 (DRVDD_1), U6.6 (VCC)
/EXP_PR: CN1.78 (EXP_PRESENT), FB32.2
/EX_3V3: C40.1, FB12.2, FB34.2, FB38.1
/GPIO1: FB1.2, P4.6
/GPIO2: FB3.2, P4.7
/GPIO3: FB8.2, P4.8
/GPIO4: FB7.1, P4.9
/GPIO5: FB9.2, P4.10
/MAC_CS: CN1.24 (P42), U6.5 (CS)
/MAC_SCK: CN1.16 (P39), U6.1 (SCK)
/MAC_SI: CN1.28 (P44), U6.3 (SI)
/MAC_SO: CN1.30 (P45), U6.4 (SO)
/P2: CN1.7 (P2), FB25.2
/P12: CN1.29 (P12), FB16.1
/P35: CN1.6 (P35), FB17.1
/P36: CN1.8 (P36), FB26.2
/P47: CN1.36 (P47), FB27.2
/P48: CN1.38 (P48), FB18.1
/P49: CN1.40 (P49), FB28.2
/P50: CN1.42 (P50), FB19.1
/P51: CN1.46 (P51), FB29.2
/P52: CN1.48 (P52), FB20.1
/P53: CN1.50 (P53), FB30.2
/P55: CN1.56 (P55), FB21.1
/P56: CN1.58 (P56), FB31.2
/P57: CN1.60 (P57), FB22.1
/PTT: FB4.2, P4.5
/RXN: C18.2, U4.37 (RX-)
/RXP: C19.2, U4.38 (RX+)
/SCK: CN1.62 (P58), U4.22 (SCLK)
/SDIO: CN1.66 (P60), U4.20 (SDIO)
/SDO: CN1.64 (P59), U4.21 (SDO)
/SEN: CN1.67 (P29), U4.23 (~SEN)
GND: C1.2, C2.2, C3.2, C4.2, C5.2, C6.2, C7.2, C8.2, C9.2, C10.2, C11.1, C12.2, C13.1, C14.2, C15.2, C16.2, C17.2, C20.2, C21.2, C22.2, C23.2, C24.2, C26.2, C27.2, C29.2, C30.2, C31.2, C33.2, C34.2, C36.2, C37.2, C38.2, C39.2, C40.2, C41.2, CN1.10 (GND), CN1.21 (GND), CN1.22 (GND), CN1.32 (AGND), CN1.33 (GND), CN1.44 (GND), CN1.53 (GND), CN1.54 (GND), CN1.76 (GND), CON1.5 (GND), D1.2 (K), P1.1, P2.1, P4.1, P6.2 (Shield), P7.2 (Shield), P8.2 (PM), Q1.1 (G), R1.1, T1.3 (S1), T2.1 (S2), U1.1 (GND), U2.1 (GND), U3.1 (OE), U3.2 (GND), U4.18 (DRVSS_1), U4.31 (AVSS_3), U4.34 (AVSS_2), U4.36 (AVSS_1), U4.39 (AVSS), U4.44 (AVSS_6), U4.47 (AVSS_5), U4.48 (AVSS_4), U4.53 (MODE), U4.54 (CONFIG), U4.55 (CLKVSS), U4.59 (DVSS), U4.62 (PWR_DWN), U4.63 (DRVSS), U4.65 (EP), U5.1 (GND), U6.2 (GND)
unnamed: C5.1, FB10.1, FB11.1, PAVDD1.1, U1.2 (VO)
unnamed: C6.1, FB12.1, PDVDD1.1, U2.2 (VO)
unnamed: C11.2, CN1.79 (5V), CN1.80 (5V), FB35.2
unnamed: C17.1, T2.5 (PM)
unnamed: C18.1, T2.4 (PR2)
unnamed: C19.1, T2.6 (PR1)
unnamed: C22.1, FB10.2, FB36.1
unnamed: C24.1, U4.42 (REFIO)
unnamed: C25.1, C28.1, C30.1, U4.33 (REFT)
unnamed: C25.2, C28.2, C31.1, U4.32 (REFB)
unnamed: C26.1, FB11.2, FB37.1
unnamed: C27.1, R4.1, T1.5 (PM)
unnamed: C29.1, FB13.1, FB15.1, Q1.3 (D)
unnamed: C32.1, T2.3 (S1)
unnamed: C32.2, C35.1, D1.1 (A)
unnamed: C33.1, FB14.1, U5.2 (VO)
unnamed: C35.2, P7.1 (Center_Conductor)
unnamed: C36.1, CON1.1 (VBUS), FB13.2
unnamed: C39.1, FB15.2, P8.1
unnamed: C41.1, FB14.2, FB39.1
unnamed: CN1.1 (3V3), CN1.2 (3V3), P3.1
unnamed: CN1.3 (RESET_EXP#), RES_EXP#1.1
unnamed: CN1.4 (PWREN#), P1.2 (PM)
unnamed: CN1.5 (P1), U4.19 (CLKOUT1)
unnamed: CN1.9 (P3), FB9.1
unnamed: CN1.11 (P4), FB8.1
unnamed: CN1.12 (P37), FB4.1
unnamed: CN1.13 (P5), FB7.2
unnamed: CN1.14 (P38), FB5.1
unnamed: CN1.15 (P6), U4.29 (PGA[0])
unnamed: CN1.17 (P7), U4.28 (PGA[1])
unnamed: CN1.18 (P40), FB1.1
unnamed: CN1.19 (P8), U4.27 (PGA[2])
unnamed: CN1.20 (P41), FB3.1
unnamed: CN1.23 (P9), U4.26 (PGA[3])
unnamed: CN1.25 (P10), U4.25 (PGA[4])
unnamed: CN1.26 (P43), FB2.1
unnamed: CN1.27 (P11), U4.24 (GAIN/PGA[5])
unnamed: CN1.31 (P13), R2.2, U4.30 (~RESET)
unnamed: CN1.34 (P46), FB6.1
unnamed: CN1.35 (P14), U4.15 (TXCLK/~TXQUIET)
unnamed: CN1.37 (P15), U4.14 (TXEN/TXSYNC)
unnamed: CN1.39 (P16), U4.13 (RXEN/RXSYNC)
unnamed: CN1.41 (P17), U4.12 (ADIO0/Rx[0])
unnamed: CN1.43 (P18), U4.11 (ADIO1/Rx[1])
unnamed: CN1.45 (P19), U4.10 (ADIO2/Rx[2])
unnamed: CN1.47 (P20), U4.9 (ADIO3/Rx[3])
unnamed: CN1.49 (P21), U4.8 (ADIO4/Rx[4])
unnamed: CN1.51 (P22), U4.7 (ADIO5/Rx[5])
unnamed: CN1.52 (P54), U4.16 (RXCLK)
unnamed: CN1.55 (P23), U4.6 (ADIO6/Tx[0])
unnamed: CN1.57 (P24), U4.5 (ADIO7/Tx[1])
unnamed: CN1.59 (P25), U4.4 (ADIO8/Tx[2])
unnamed: CN1.61 (P26), U4.3 (ADIO9/Tx[3])
unnamed: CN1.63 (P27), U4.2 (ADIO10/Tx[4])
unnamed: CN1.65 (P28), U4.1 (ADIO11/Tx[5])
unnamed: FB16.2, P2.3
unnamed: FB17.2, P2.5
unnamed: FB18.2, P2.7
unnamed: FB19.2, P2.9
unnamed: FB20.2, P2.11
unnamed: FB21.2, P2.13
unnamed: FB22.2, P2.15
unnamed: FB23.1, SP1.1
unnamed: FB23.2, P2.17
unnamed: FB24.1, SP2.1
unnamed: FB24.2, P2.19
unnamed: FB25.1, P2.2
unnamed: FB26.1, P2.4
unnamed: FB27.1, P2.6
unnamed: FB28.1, P2.8
unnamed: FB29.1, P2.10
unnamed: FB30.1, P2.12
unnamed: FB31.1, P2.14
unnamed: FB32.1, P2.16
unnamed: FB33.1, P2.18
unnamed: FB33.2, SP3.1
unnamed: FB34.1, P2.20
unnamed: P6.1 (Center_Conductor), T1.1 (S2)
unnamed: P9.1, U4.49 (IOUT_G+)
unnamed: P10.1, U4.45 (IOUT_G-)
unnamed: R1.2, U4.41 (REFADJ)
unnamed: R3.1, T1.4 (PR1), U4.50 (IOUT_N+)
unnamed: R3.2, T1.6 (PR2), U4.46 (IOUT_N-)
unnamed: U3.3 (CLK), U4.57 (OSCIN)
VIN: C1.1, C2.1, C3.1, C4.1, C13.2, C20.1, C21.1, C23.1, FB35.1, P5V0.1, Q1.2 (S), R4.2, U1.3 (VI), U2.3 (VI), U5.3 (VI)

Notes on the sheet:
Bandpass Filter/PA Interface
RCVR_IN
TX_OUT
Disconnect jumper to program, but only when BeMicro is connected to a powered USB port.
+5 VDC connector
MAC/IP Address EEPROM
1) Needs review again!
Spare 5V input.
Note: T2 can be replaced with a Ruthoff 4:1 balanced to unbalanced transformer, and C17 can then be left unpopulated.
T1 trifilar wound on binocular core. Minicircuits ADT9-1T is not rated for the DC current (105 mA).
Spares Connector

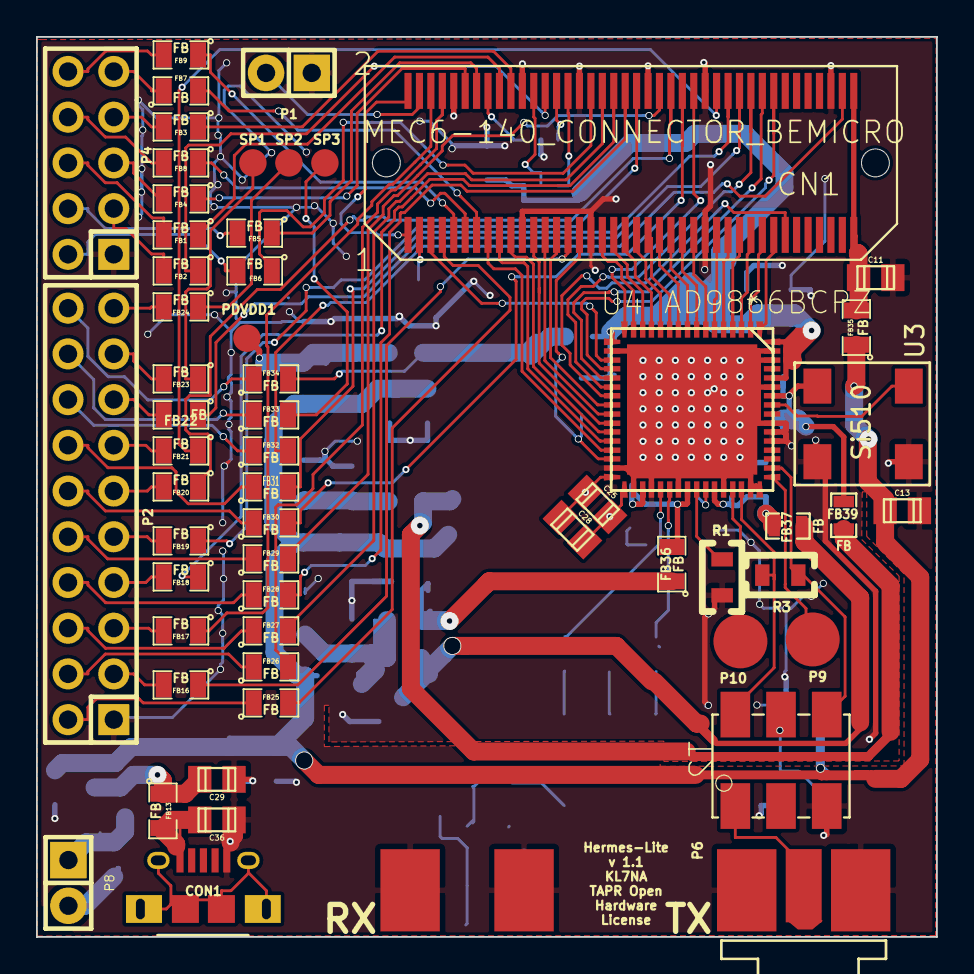
[picture p49: board ad9866_2.kicad_pcb from above]

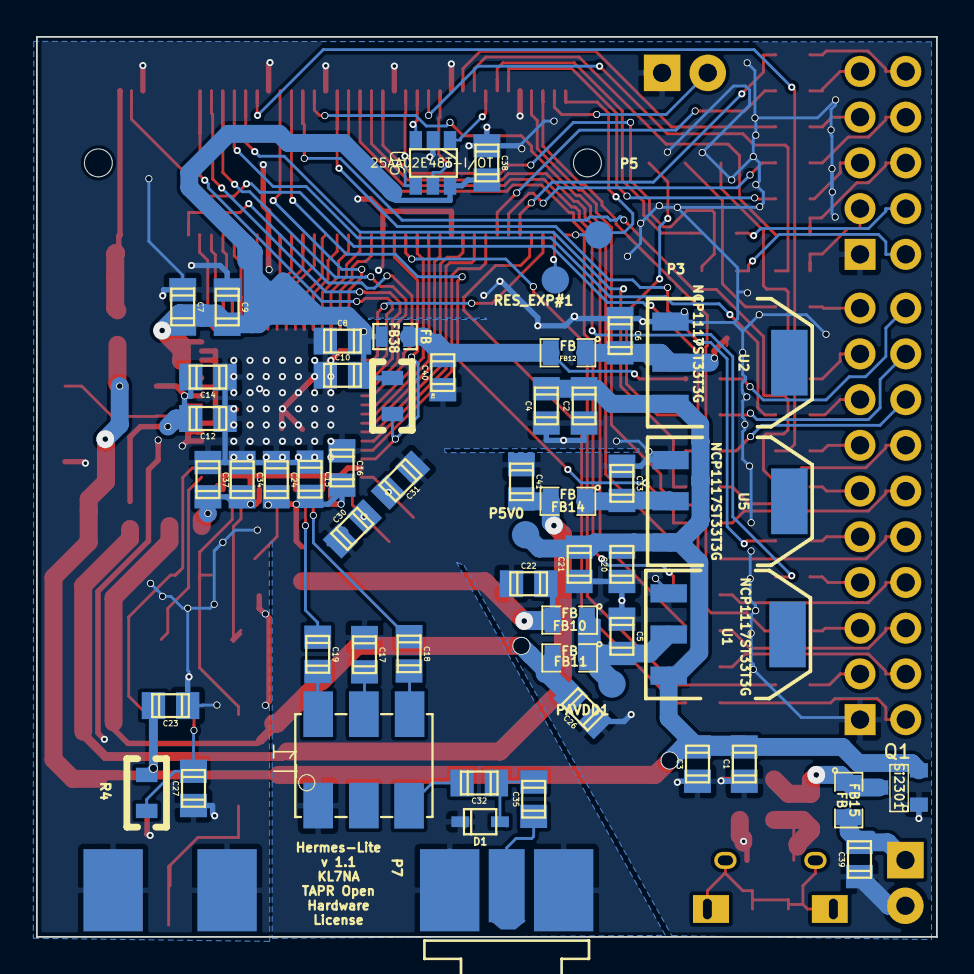
[picture p50: board ad9866_2.kicad_pcb from below]

Board: 4 copper layers, 50.0 x 50.0 mm, 113 parts (56 on the bottom side), 126 nets.

Other parts of the board:
P5: CONN_1; Measurement_Point_Round-SMD-Pad_Small
