frohro/Hermes-Lite/(commit log)

2014-06-16 Initial v-1.1 commit
    [ad9866_2.dsn, ad9866_2.kicad_pcb, ad9866_2.sch]
2014-06-16 adding libraries needed
    [ad9866.kicad_pcb, ad9866.sch]
2014-06-17 ground plane revisions
    [ad9866_2.kicad_pcb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]
2014-06-19 Revised after first review.
    [ad9866_2.dsn, ad9866_2.kicad_pcb, ad9866_2.sch]
2014-06-19 Added a slit to separate DVDD and AVDD_ADC, and provisions for shield.
    [ad9866_2.kicad_pcb]
2014-06-20 Added all the libs dir.
    [ad9866_2.kicad_pcb]
2014-06-20 Fixed the ADC reference caps.
    [ad9866_2.kicad_pcb]
2014-06-20 Added doc link for ferrite beads.
    [AB2_USB_MICRO_SMD.stl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]
2014-06-20 Added more FB's and bypass caps.
    [ad9866_2.kicad_pcb, ad9866_2.sch]
2014-06-20 Added thermal relief.
    [ad9866_2.kicad_pcb]
2014-06-20 Special attention to the routing of CLKOUT1.
    [ad9866_2.kicad_pcb]
2014-06-20 Special attention to the routing of CLKOUT1, added cutout & filled.
    [ad9866_2.kicad_pcb]
2014-06-20 Special attention to the routing of CLKOUT1, added more ground plane.
    [ad9866_2.kicad_pcb]
2014-06-20 Removed a few 90 degree corners, cleaned up a few traces.
    [ad9866_2.kicad_pcb]
2014-06-21 Removed the solder mask to make installing copper tape shields.
    [ad9866_2-B_Cu.gbl, ad9866_2-B_Mask.gbs, ad9866_2-B_Paste.gbp, ad9866_2-B_SilkS.gbo, ad9866_2-Edge_Cuts.gbr, ad9866_2-F_Cu.gtl, ad9866_2-F_Mask.gts, ad9866_2-F_Paste.gtp]
2014-06-22 Made power traces much wider where possible.
    [ad9866_2.kicad_pcb]
2014-06-23 Filled in ground plane where I could, and made DRC work again.
    [ad9866_2.kicad_pcb]
2014-06-23 Filled in a few more places on the ground plane.
    [ad9866_2.kicad_pcb]
2014-06-25 Deleted a via way out in right field. Still passes DRC.
    [ad9866_2-B_Cu.gbl, ad9866_2-B_Mask.gbs, ad9866_2-B_Paste.gbp, ad9866_2-B_SilkS.gbo, ad9866_2-Edge_Cuts.gbr, ad9866_2-F_Cu.gtl, ad9866_2-F_Mask.gts, ad9866_2-F_Paste.gtp]
2014-06-25 New Gerbers.
    [ad9866.sch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]
2014-06-25 Changed schematic and .cmp for issues 12 & 16-20
    [ad9866.sch]
2014-06-25 Think 12 is fixed; routed by hand all changes.
    [ad9866.kicad_pcb]
2014-06-25 Just making sure everything is saved.
    [ad9866.kicad_pcb]
2014-06-26 to switch branches
2014-06-26 Changed the SMA to SMA edge connectors, because then they are the same as the other board, and to get around the slight possibility the holes still are not right.
    [ad9866.kicad_pcb, ad9866.sch]
2014-06-26 version submitted.
    [ad9866.kicad_pcb]
2014-06-29 Fixed the holes in the SMA Edge connectors to be 0.3 mm.
    [ad9866.kicad_pcb]
2014-06-30 Fixed soldermask on P23-25.
    [ad9866.kicad_pcb]
2014-06-30 Fixed SMA connectors correctly this time.
    [ad9866.kicad_pcb]
2014-07-15 Added the bottom ground plane in.
    [ad9866.kicad_pcb, ad9866.ods, ad9866.sch]
