frohro/Hermes-Lite/(notices)

Notices in the files:
pcb/ad9866.kicad_pcb:
Copyright 2014
